adeboni/laser-projector/README.md

# Room-scale Quad Laser Projecter

This project is for a quadruple laser projection controller, aimed at supporting room-scale projections
