adeboni/laser-projector/2024/hardware/combo_laser_driver/notes.txt

Laser Diode Settings:
Red = 3.3 V / 46 mA
Green = 7.2 V / 27 mA
Blue = 7.2 V / 44 mA
