adeboni/laser-projector/2023/hardware/15v_power/15v_power.step

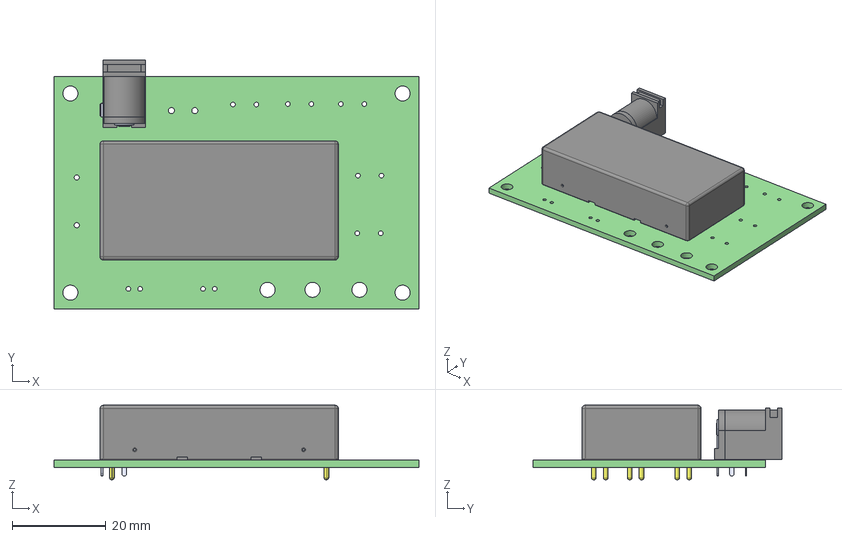
[picture p1: CAD file, 2022-12-08]
2023/hardware/15v_power/15v_power.step
77.8 x 53.1 x 15.9 mm
15v_power PCB
