adeboni/laser-projector/2023/hardware/4x_laser_controller_fp/4x_laser_controller_fp.step

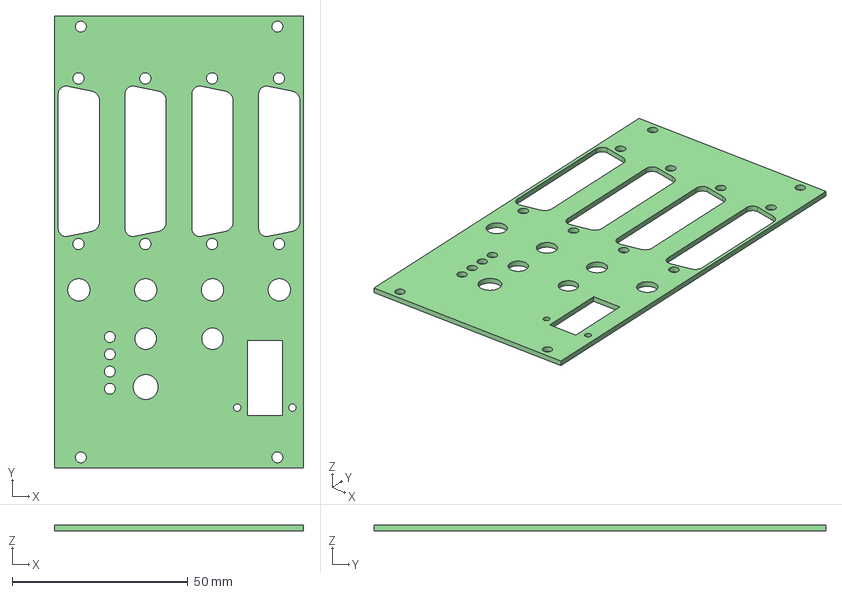
[picture p2: CAD file, 2022-12-08]
2023/hardware/4x_laser_controller_fp/4x_laser_controller_fp.step
70.8 x 128.5 x 1.60 mm
