adeboni/laser-projector/2023/software/extras/cube.stl

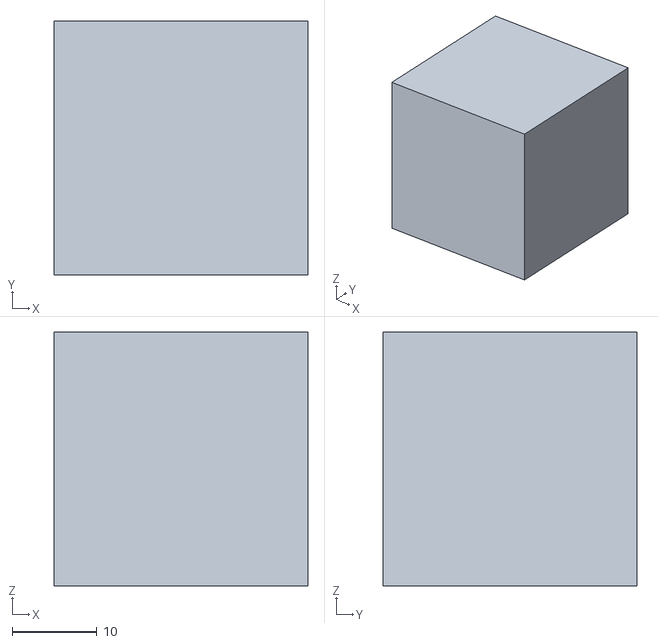
[picture p3: CAD file, 2022-12-08]
2023/software/extras/cube.stl
30.0 x 30.0 x 30.0
