adeboni/laser-projector/2024/hardware/combo_laser_driver/cad/LDNP-470MC--3DModel-STEP-56544.STEP

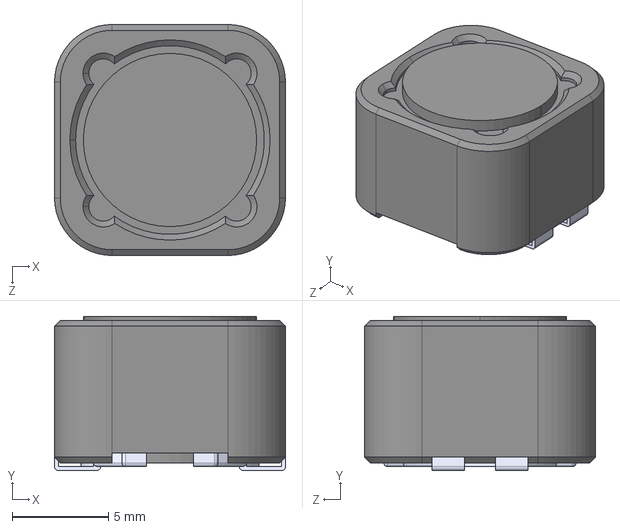
[picture p4: CAD file, 2023-11-15]
2024/hardware/combo_laser_driver/cad/LDNP-470MC--3DModel-STEP-56544.STEP
12.0 x 8.00 x 12.0 mm
