adeboni/laser-projector/2024/hardware/combo_laser_driver/cad/c-0641737-01-g-3d.stp

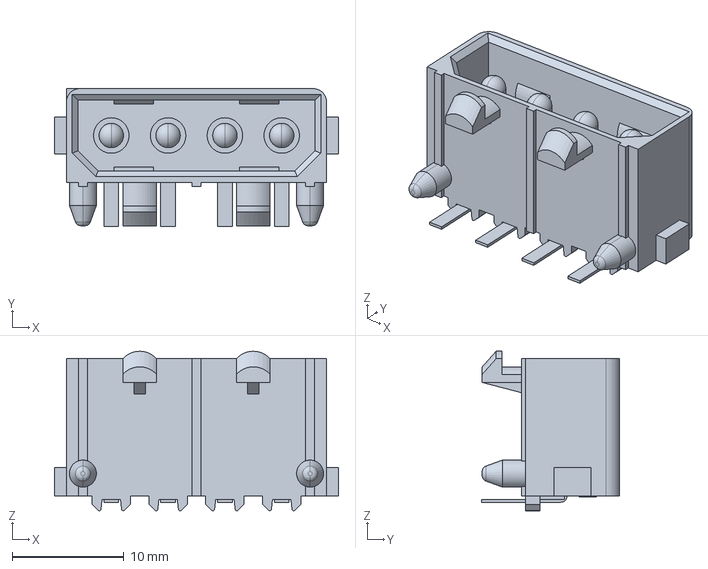
[picture p5: CAD file, 2023-11-15]
2024/hardware/combo_laser_driver/cad/c-0641737-01-g-3d.stp
25.4 x 12.3 x 14.3 mm
