adeboni/laser-projector/2024/hardware/combo_laser_driver/cad/CSP-USC16-TR--3DModel-STEP-468060.STEP

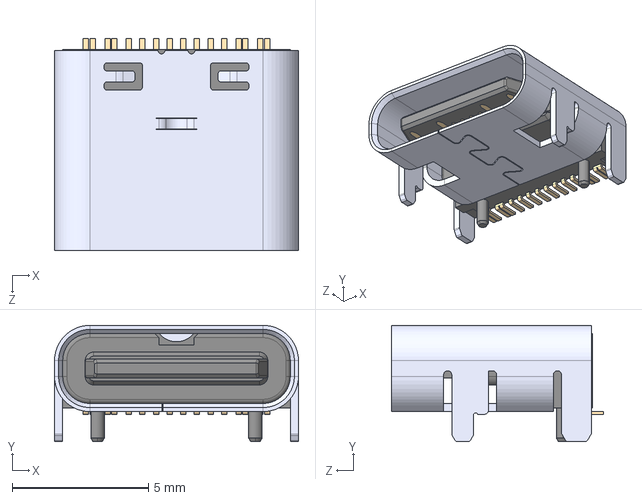
[picture p6: CAD file, 2023-11-15]
2024/hardware/combo_laser_driver/cad/CSP-USC16-TR--3DModel-STEP-468060.STEP
8.94 x 4.26 x 7.75 mm
