adeboni/laser-projector/2024/hardware/combo_laser_driver/cad/7499010121A (rev1).stp

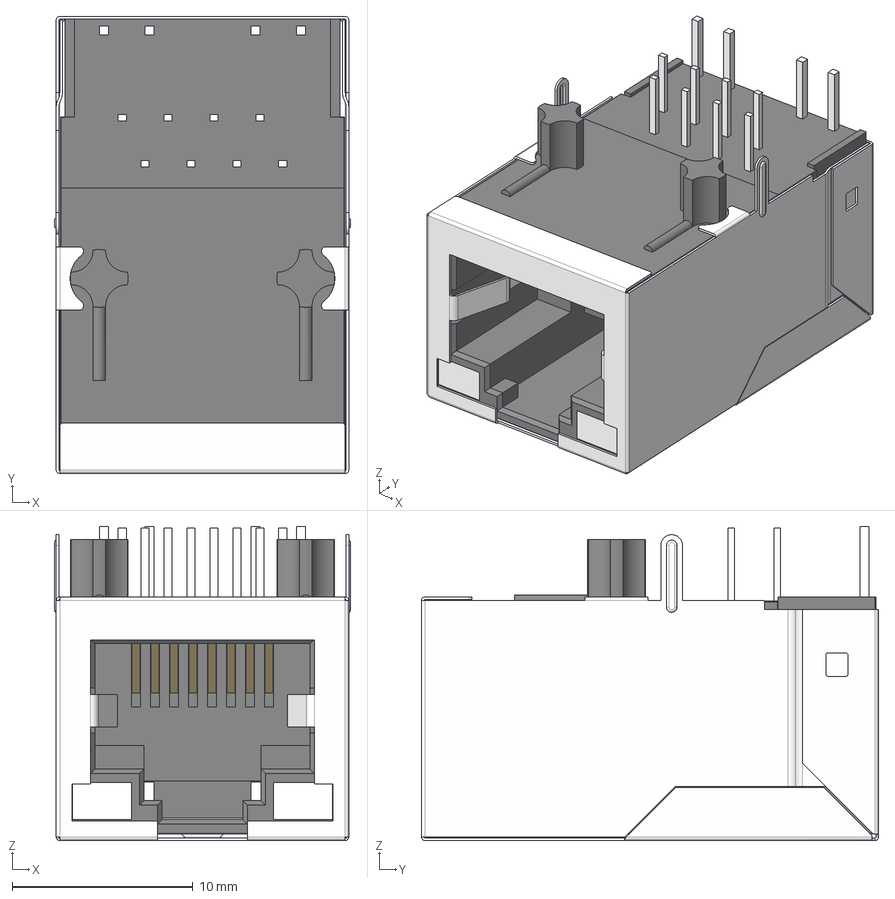
[picture p7: CAD file, 2023-11-15]
2024/hardware/combo_laser_driver/cad/7499010121A (rev1).stp
16.4 x 25.3 x 17.4 mm
Insulator
Insulator_2
Shielding
LED x 2
