adeboni/laser-projector/2024/hardware/combo_laser_driver/cad/76829-0004--3DModel-STEP-194946.STEP

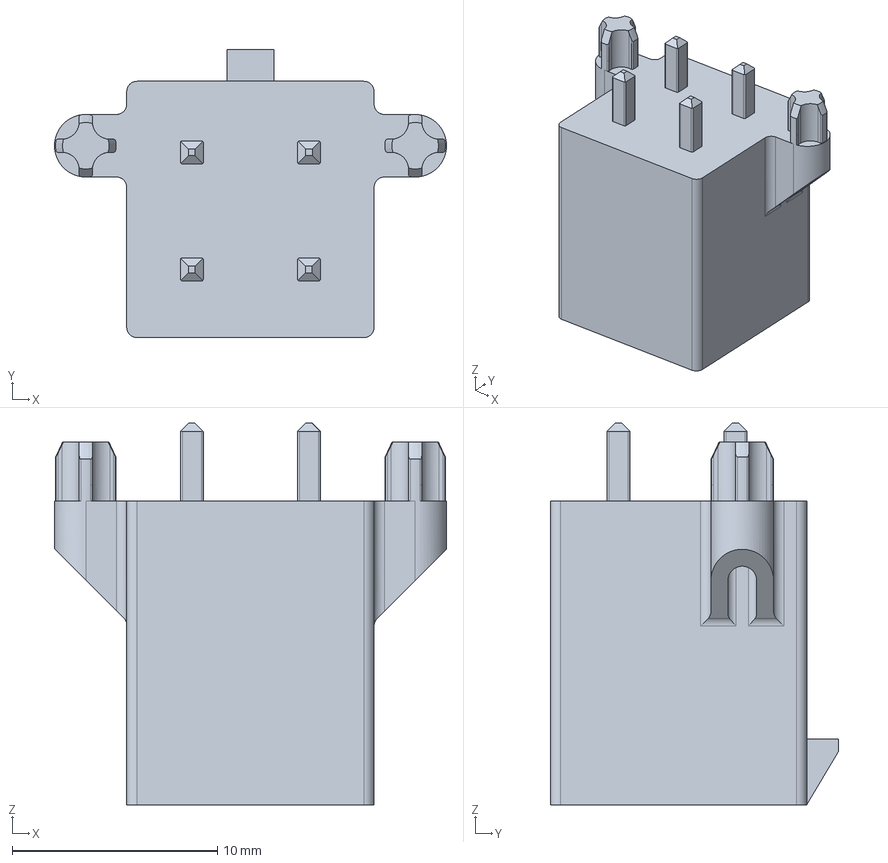
[picture p8: CAD file, 2023-11-15]
2024/hardware/combo_laser_driver/cad/76829-0004--3DModel-STEP-194946.STEP
19.1 x 14.0 x 18.6 mm
