adeboni/laser-projector/2024/hardware/combo_laser_driver/combo_laser_driver.pdf

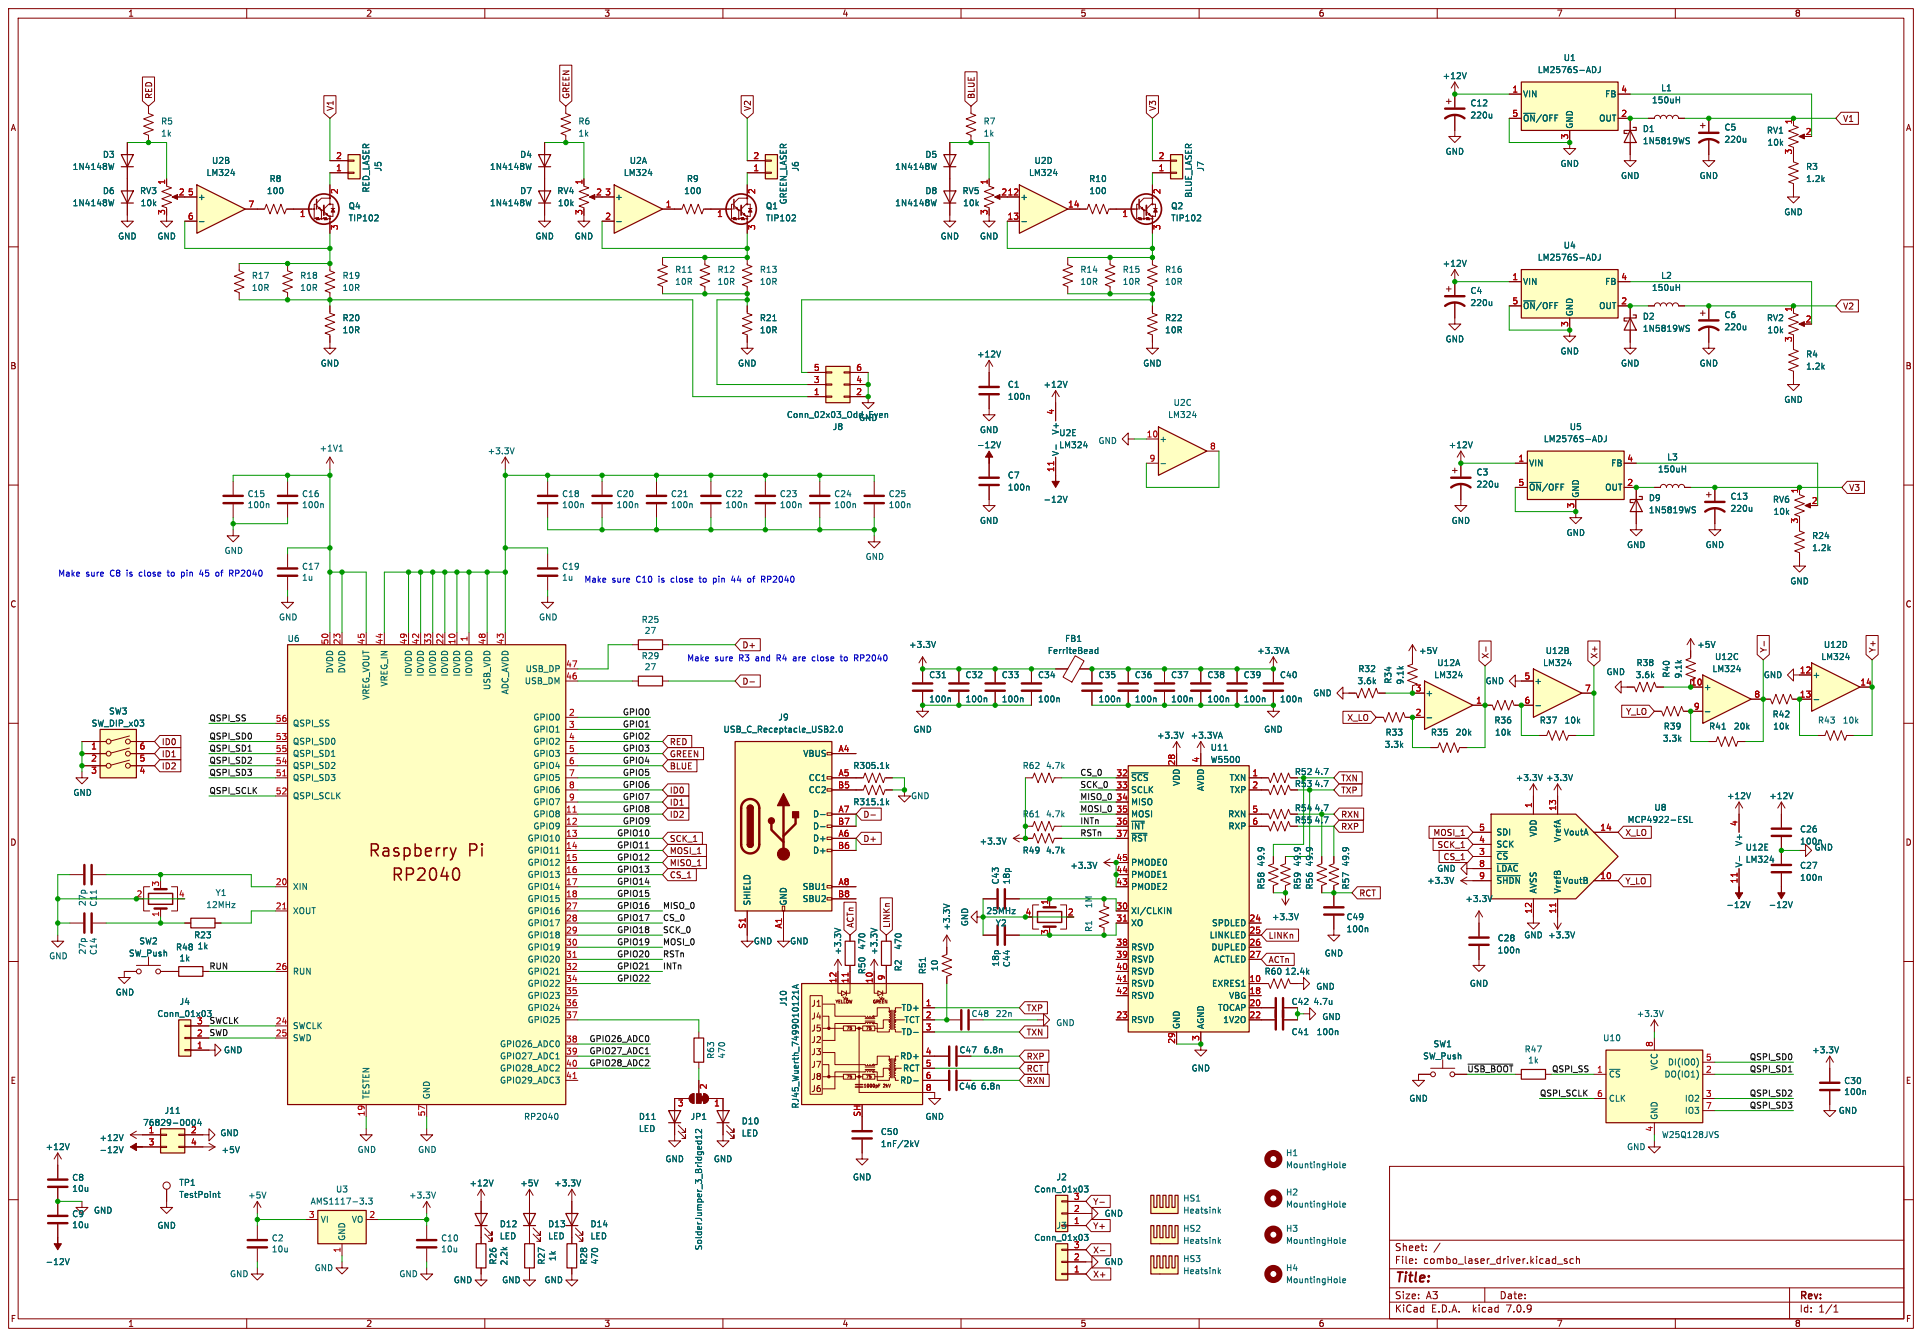
[picture p9: page 1]

3 FB 4 ~{ON}/OFF 5 GND

3 FB 4 ~{ON}/OFF 5 GND GND

1 IOVDD 10 GPIO8 11 GPIO9 12 GPIO10 13 GPIO11 14 GPIO12 15 GPIO13 16 GPIO14 17 GPIO15 18 TESTEN 19 GPIO0 2 XIN 20 XOUT 21 IOVDD 22 DVDD 23 SWCLK 24 SWD 25 RUN 26 GPIO16 27 GPIO17 28 GPIO18 29 GPIO1 3 GPIO19 30 GPIO20 31 GPIO21 32 IOVDD 33 GPIO22 34 GPIO23 35 GPIO24 36 GPIO25 37 GPIO26_ADC0 38 GPIO27_ADC1 39 GPIO2 4 GPIO28_ADC2 40 GPIO29_ADC3 41 IOVDD 42 ADC_AVDD 43 VREG_IN 44 VREG_VOUT 45 USB_DM 46 USB_DP 47 USB_VDD 48 IOVDD 49 GPIO3 5 DVDD 50 QSPI_SD3 51 QSPI_SCLK 52 QSPI_SD0 53 QSPI_SD2 54 QSPI_SD1 55 QSPI_SS 56 GND 57 GPIO4 6 GPIO5 7 GPIO6 8 GPIO7 9 U6 RP2040

4 RSVD 40 RSVD 41 RSVD 42 PMODE2 43 PMODE1 44 PMODE0 45 RXN 5 RXP 6 +3.3V C35

4 RSVD 40 RSVD 41 RSVD 42 PMODE2 43 PMODE1 44 PMODE0 45 RXN 5 RXP 6 U11 W5500 +3.3V

3 XI/CLKIN 30 XO 31 ~{SCS} 32 SCLK 33 MISO 34 MOSI 35 ~{INT} 36 ~{RST} 37 RSVD 38 RSVD 39 AVDD

1 VoutB 10 VrefB 11 AVSS 12 VrefA 13 VoutA 14 ~{CS} 3 SCK 4 SDI 5 ~{LDAC} 8 ~{SHDN} 9 U8 MCP4922-ESL +3.3V

1 VoutB 10 VrefB 11 AVSS 12 VrefA 13 VoutA 14 ~{CS} 3 SCK 4 SDI 5 ~{LDAC} 8 ~{SHDN} 9 +3.3V

1 VO 2 VI 3 U3 AMS1117-3.3 GND GND

H3 MountingHole H4 MountingHole H1 MountingHole H2 MountingHole GND

Id: 1/1 Title: File: combo_laser_driver.kicad_sch Sheet: /
