adeboni/laser-projector/2023/hardware/mini_laser_driver/mini_laser_driver.kicad_pcb

## KiCad design 2023/hardware/mini_laser_driver/mini_laser_driver.kicad_pcb (2023-01-10)

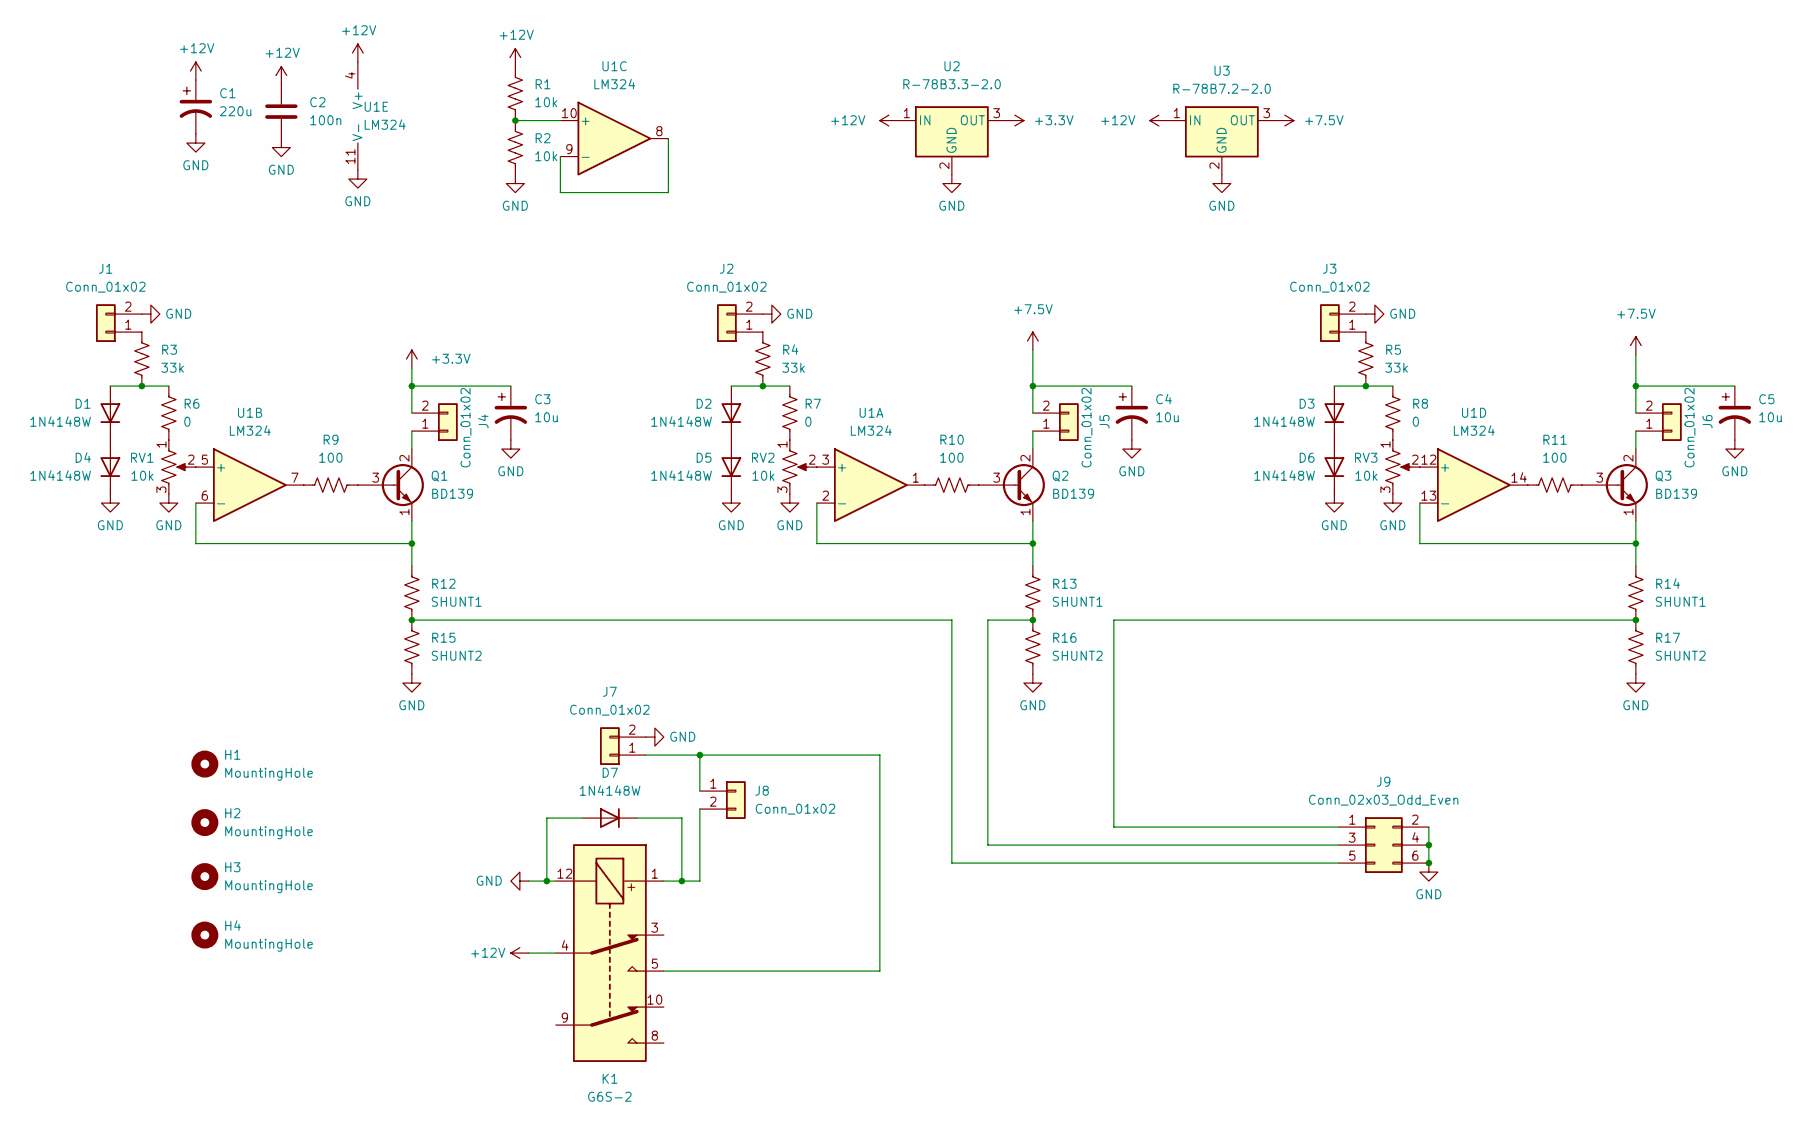
[picture p10: schematic mini_laser_driver.kicad_sch]

Parts:
C1: 220u; CP_Radial_D10.0mm_P5.00mm
C2: 100n; C_0603_1608Metric
C3, C4, C5: 10u; CP_Radial_D5.0mm_P2.50mm
D1, D2, D3, D4, D5, D6, D7: 1N4148W; D_SOD-123
H1, H2, H3, H4: MountingHole; MountingHole_3.2mm_M3
J1, J2, J3, J4, J5, J6, J7: Conn_01x02; JST_XH_B2B-XH-A_1x02_P2.50mm_Vertical
J8: Conn_01x02; PinHeader_1x02_P2.54mm_Vertical
J9: Conn_02x03_Odd_Even; PinHeader_2x03_P2.54mm_Vertical
K1: G6S-2; Relay_DPDT_Omron_G6S-2
Q1, Q2, Q3: BD139; TO-126-3_Vertical
R1, R2: 10k; R_0603_1608Metric
R3, R4, R5: 33k; R_0603_1608Metric
R6, R7, R8: 0; R_0603_1608Metric
R9, R10, R11: 100; R_0603_1608Metric
R12, R13, R14: SHUNT1; R_Axial_DIN0204_L3.6mm_D1.6mm_P1.90mm_Vertical
R15, R16, R17: SHUNT2; R_Axial_DIN0204_L3.6mm_D1.6mm_P1.90mm_Vertical
RV1, RV2, RV3: 10k; Potentiometer_Bourns_3296W_Vertical
U1: LM324; SOIC-14_3.9x8.7mm_P1.27mm
U2: R-78B3.3-2.0; Converter_DCDC_RECOM_R-78B-2.0_THT
U3: R-78B7.2-2.0; Converter_DCDC_RECOM_R-78B-2.0_THT

Connections:
+3V3: C3.1, J4.2, U2.3 (OUT)
+7.5V: C4.1, C5.1, J5.2, J6.2, U3.3 (OUT)
+12V: C1.1, C2.1, K1.4, R1.2, U1.4 (V+), U2.1 (IN), U3.1 (IN)
GND: C1.2, C2.2, C3.2, C4.2, C5.2, D4.1 (K), D5.1 (K), D6.1 (K), D7.2 (A), J1.2, J2.2, J3.2, J7.2, J9.2, J9.4, J9.6, K1.12, R2.1, R15.2, R16.2, R17.2, RV1.3, RV2.3, RV3.3, U1.11 (V-), U2.2 (GND), U3.2 (GND)
unnamed: D1.1 (K), D4.2 (A)
unnamed: D1.2 (A), R3.1, R6.2
unnamed: D2.1 (K), D5.2 (A)
unnamed: D2.2 (A), R4.1, R7.2
unnamed: D3.1 (K), D6.2 (A)
unnamed: D3.2 (A), R5.1, R8.2
unnamed: D7.1 (K), J8.2, K1.1
unnamed: J1.1, R3.2
unnamed: J2.1, R4.2
unnamed: J3.1, R5.2
unnamed: J4.1, Q1.2 (C)
unnamed: J5.1, Q2.2 (C)
unnamed: J6.1, Q3.2 (C)
unnamed: J7.1, J8.1, K1.5
unnamed: J9.1, R14.2, R17.1
unnamed: J9.3, R13.2, R16.1
unnamed: Q1.1 (E), R12.1, U1.6 (-)
unnamed: Q1.3 (B), R9.2
unnamed: Q2.1 (E), R13.1, U1.2 (-)
unnamed: Q2.3 (B), R10.2
unnamed: Q3.1 (E), R14.1, U1.13 (-)
unnamed: Q3.3 (B), R11.2
unnamed: R1.1, R2.2, U1.10 (+)
unnamed: R6.1, RV1.1
unnamed: R7.1, RV2.1
unnamed: R8.1, RV3.1
unnamed: R9.1, U1.7
unnamed: R10.1, U1.1
unnamed: R11.1, U1.14
unnamed: J9.5, R12.2, R15.1
unnamed: RV1.2, U1.5 (+)
unnamed: RV2.2, U1.3 (+)
unnamed: RV3.2, U1.12 (+)
unnamed: U1.8, U1.9 (-)

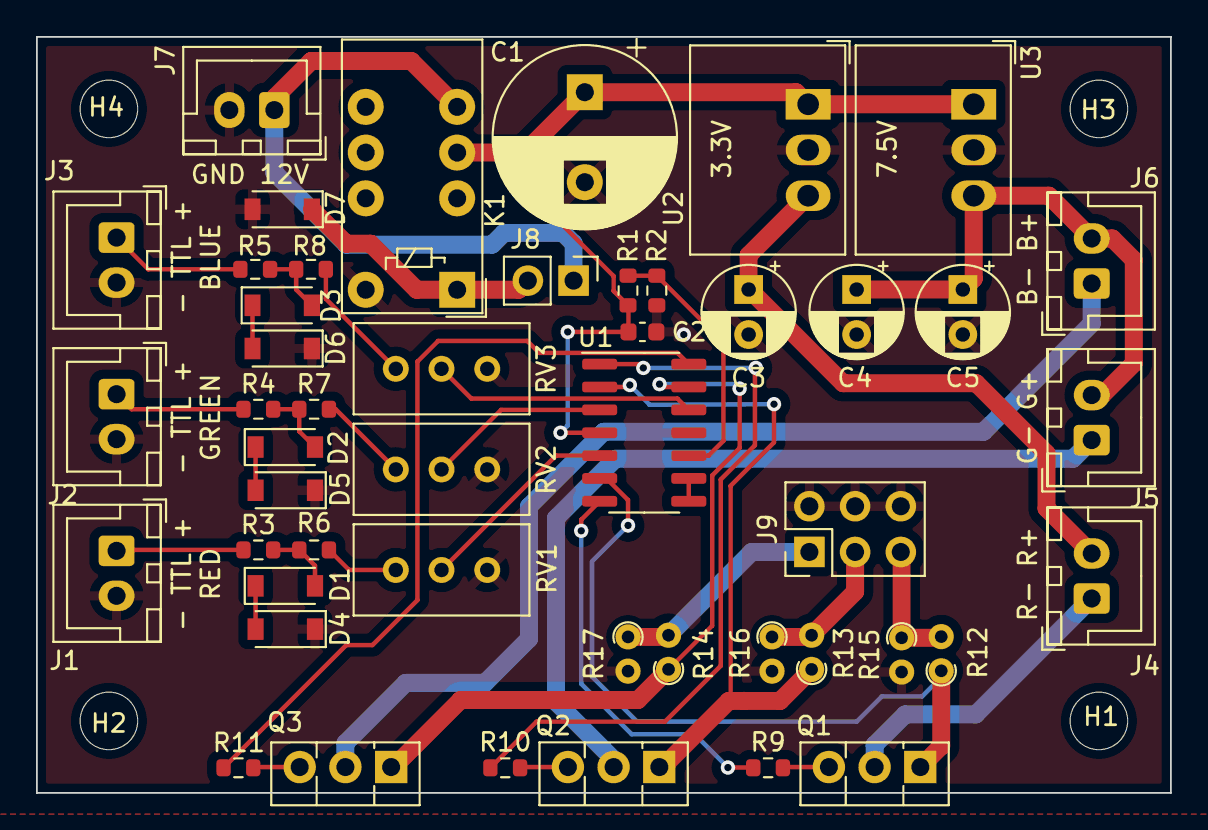
[picture p11: board mini_laser_driver.kicad_pcb from above]

Board: 2 copper layers, 63.0 x 42.0 mm, 52 parts (0 on the bottom side), 38 nets.
