adeboni/laser-projector/2023/hardware/canbus_controller/canbus_controller.kicad_pcb

## KiCad design 2023/hardware/canbus_controller/canbus_controller.kicad_pcb (2023-11-15)

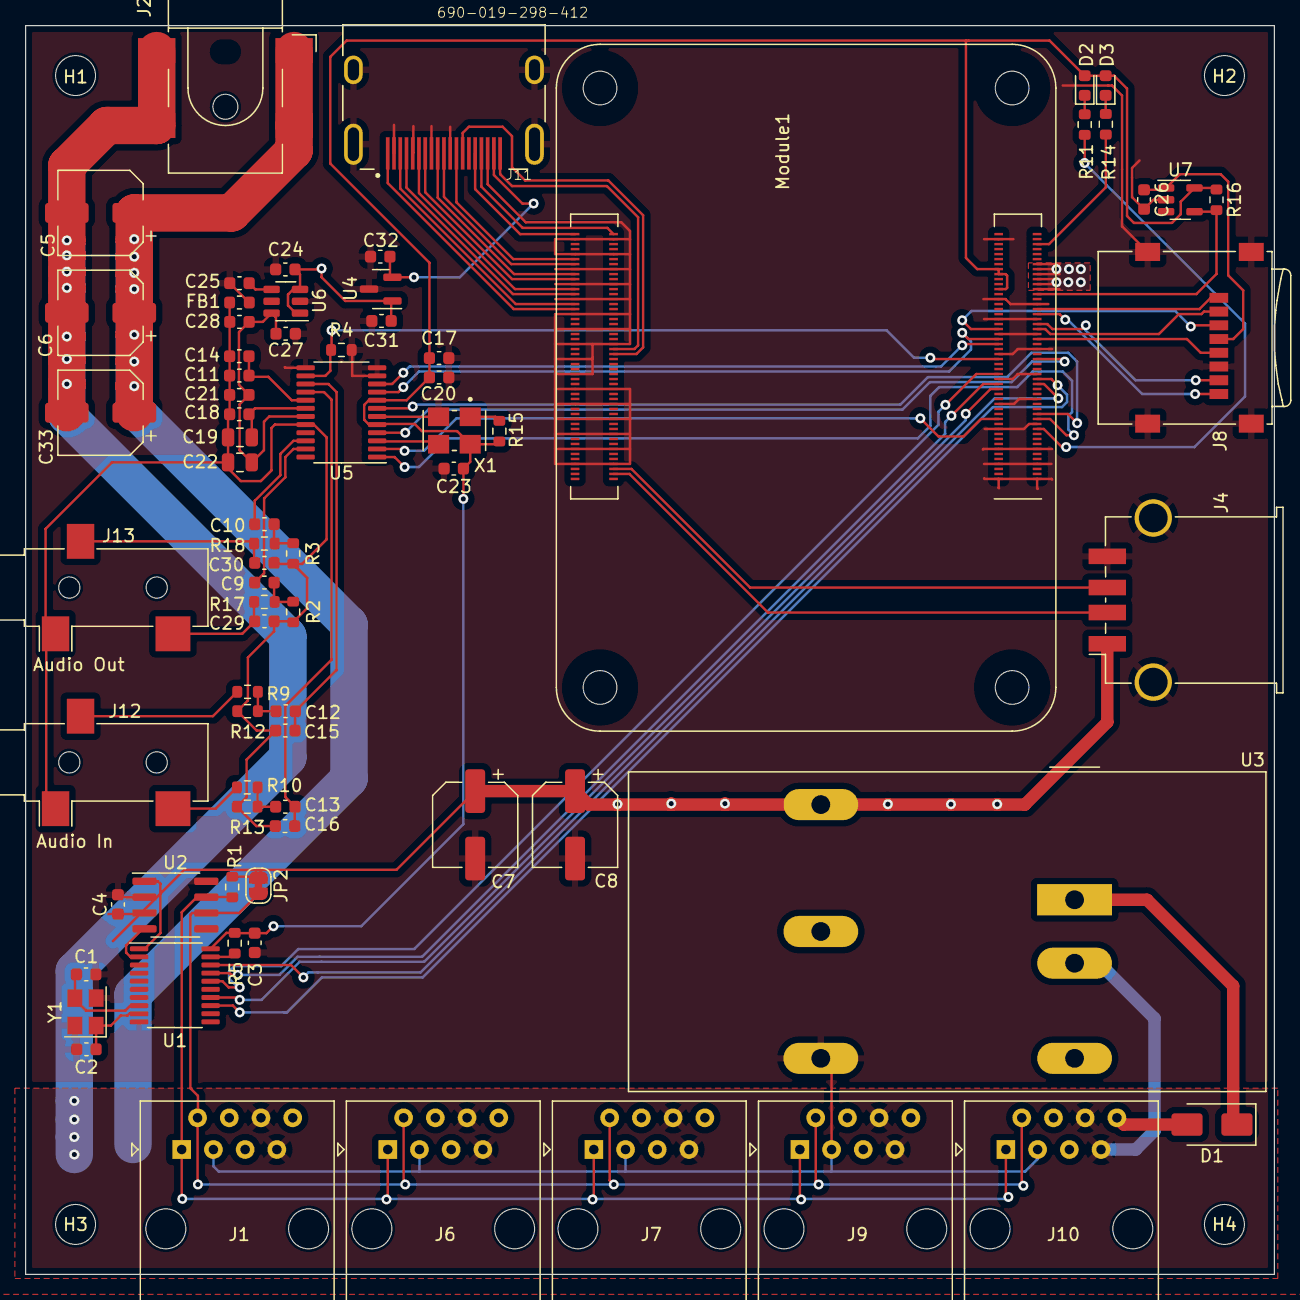
[picture p14: board canbus_controller.kicad_pcb from above]

Board: 2 copper layers, 100.0 x 100.0 mm, 78 parts (0 on the bottom side), 72 nets.

Parts:
C1, C2: 27p; C_0603_1608Metric
C3, C4, C11, C18, C20, C21, C24, C28, C31, C32: 100n; C_0603_1608Metric
C5, C6, C7, C8, C33: 100u; CP_Elec_6.3x5.8
C9, C10: 3.3u; C_0603_1608Metric
C12, C13, C14, C17, C26, C27: 10u; C_0603_1608Metric
C15, C16: 220p; C_0603_1608Metric
C19, C22: 47u; C_0805_2012Metric
C23, C25: 10n; C_0603_1608Metric
C29, C30: 2.7n; C_0603_1608Metric
D1: SS54; D_SMA
D2: LED Green; LED_0603_1608Metric
D3: LED Red; LED_0603_1608Metric
FB1: FerriteBead_Small; L_0603_1608Metric
H1, H2, H3, H4: MountingHole; MountingHole_3.2mm_M3
J1, J6, J7, J9, J10: RJ45; RJ45_Amphenol_54602-x08_Horizontal
J2: Barrel_Jack_Switch; BarrelJack_CLIFF_FC681465S_SMT_Horizontal
J4: USB_A; USB_A_TE_292303-7_Horizontal
J8: Micro_SD_Card; microSD_HC_Wuerth_693072010801
J11: 690-019-298-412; EDAC 690-019-298-412
J12, J13: AudioJack3; Jack_3.5mm_CUI_SJ-3523-SMT_Horizontal
JP2: SolderJumper_2_Bridged; SolderJumper-2_P1.3mm_Bridged_RoundedPad1.0x1.5mm
Module1: ComputeModule4; Raspberry-Pi-4-Compute-Module
R1: 120; R_0603_1608Metric
R2, R3, R4, R5, R12, R13, R15: 10k; R_0603_1608Metric
R9, R10: 4.99k; R_0603_1608Metric
R11, R14: 1k; R_0603_1608Metric
R16: 12K 1%; R_0603_1608Metric
R17, R18: 590; R_0603_1608Metric
U1: MCP2515-xST; TSSOP-20_4.4x6.5mm_P0.65mm
U2: MCP2551-I-SN; SOIC-8_3.9x4.9mm_P1.27mm
U3: TEN20-2411WIN; Converter_DCDC_TRACO_TEN20-xxxx_THT
U4: RT9742SNGV; SOT-23
U5: CS4270; TSSOP-24_4.4x7.8mm_P0.65mm
U6: TPS79301-EP; SOT-23-6
U7: RT9742GGJ5; SOT-23-5
X1: 12.288MHz; XTAL_ASFL1-8.000MHZ-EC-T
Y1: 8Mhz; Crystal_SMD_3225-4Pin_3.2x2.5mm

Connections:
+5VA: C21.1, C22.1, C27.1, C28.1, U5.19 (VA), U6.6 (OUT)
/+3.3v: C3.1, C17.1, C20.1, C23.1, D2.2 (A), D3.2 (A), Module1.78 (GPIO_VREF(1.8v/3.3v_Input)), Module1.84 (+3.3v_(Output)), Module1.86 (+3.3v_(Output)), R5.2, R15.1, R16.1, U1.20 (VDD), U5.5 (VD), U5.8 (VLC), U7.5 (IN), X1.4 (Vdd)
/+5v: C4.1, C7.1, C8.1, C24.1, C31.1, J4.1 (VBUS), Module1.77 (+5v_(Input)), Module1.79 (+5v_(Input)), Module1.81 (+5v_(Input)), Module1.83 (+5v_(Input)), Module1.85 (+5v_(Input)), Module1.87 (+5v_(Input)), U2.3 (VDD), U3.3 (VOUT+), U4.1 (IN), U6.1 (IN), U6.3 (EN)
/+12v: C5.1, C6.1, C33.1, D1.2 (A), J1.5, J1.8, J2.1, J6.5, J6.8, J7.5, J7.8, J9.5, J9.8, J10.5, J10.8
/HDMI0_CEC: J11.13 (CEC), Module1.151 (HDMI0_CEC)
/HDMI0_CK_N: J11.12 (CK-), Module1.190 (HDMI0_CLK_N)
/HDMI0_CK_P: J11.10 (CK+), Module1.188 (HDMI0_CLK_P)
/HDMI0_D0_N: J11.9 (D0-), Module1.184 (HDMI0_TX0_N)
/HDMI0_D0_P: J11.7 (D0+), Module1.182 (HDMI0_TX0_P)
/HDMI0_D1_N: J11.6 (D1-), Module1.178 (HDMI0_TX1_N)
/HDMI0_D1_P: J11.4 (D1+), Module1.176 (HDMI0_TX1_P)
/HDMI0_D2_N: J11.3 (D2-), Module1.172 (HDMI0_TX2_N)
/HDMI0_D2_P: J11.1 (D2+), Module1.170 (HDMI0_TX2_P)
/HDMI0_HOTPLUG: J11.19 (HPD/HEAC-), Module1.153 (HDMI0_HOTPLUG)
/HDMI0_SCL: J11.15 (SCL), Module1.200 (HDMI0_SCL)
/HDMI0_SDA: J11.16 (SDA), Module1.199 (HDMI0_SDA)
/HDMI_5v: C32.1, J11.18 (+5V), U4.2 (OUT)
/SD_CLK: J8.5 (CLK), Module1.57 (SD_CLK)
/SD_CMD: J8.3 (CMD), Module1.62 (SD_CMD)
/SD_DAT0: J8.7 (DAT0), Module1.63 (SD_DAT0)
/SD_DAT1: J8.8 (DAT1), Module1.67 (SD_DAT1)
/SD_DAT2: J8.1 (DAT2), Module1.69 (SD_DAT2)
/SD_DAT3: J8.2 (DAT3/CD), Module1.61 (SD_DAT3)
/SD_PWR: C26.1, J8.4 (VDD), U7.1 (OUT)
/SD_PWR_ON: Module1.75 (SD_PWR_ON), R16.2, U7.4 (EN)
/USBD_N: J4.2 (D-), Module1.103 (USB2_N)
/USBD_P: J4.3 (D+), Module1.105 (USB2_P)
/nPWR_LED: Module1.95 (nPI_LED_PWR), R14.2
CAN_CS: Module1.39 (GPIO8), U1.18 (~CS)
CAN_H: J1.1, J6.1, J7.1, J9.1, J10.1, R1.2, U2.7 (CANH)
CAN_L: J1.2, J6.2, J7.2, J9.2, J10.2, JP2.2 (B), U2.6 (CANL)
CAN_SCK: Module1.38 (GPIO11), U1.14 (SCK)
CAN_SI: Module1.44 (GPIO10), U1.16 (SI)
CAN_SO: Module1.40 (GPIO9), U1.17 (SO)
GND: C1.2, C2.2, C3.2, C4.2, C7.2, C8.2, C17.2, C20.2, C23.2, C24.2, C25.2, C26.2, C27.2, C31.2, C32.2, FB1.2, J1.3, J4.4 (GND), J4.5 (Shield), J6.3, J7.3, J8.6 (VSS), J8.9 (SHIELD), J9.3, J10.3, J11.2 (D2S), J11.5 (D1S), J11.8 (D0S), J11.11 (CKS), J11.17 (GND), J11.SH1 (SH), J11.SH2 (SH), J11.SH3 (SH), J11.SH4 (SH), Module1.1 (GND), Module1.2 (GND), Module1.7 (GND), Module1.8 (GND), Module1.13 (GND), Module1.14 (GND), Module1.22 (GND), Module1.23 (GND), Module1.32 (GND), Module1.33 (GND), Module1.42 (GND), Module1.43 (GND), Module1.52 (GND), Module1.53 (GND), Module1.59 (GND), Module1.60 (GND), Module1.65 (GND), Module1.66 (GND), Module1.71 (GND), Module1.74 (GND), Module1.98 (GND), Module1.107 (GND), Module1.108 (GND), Module1.113 (GND), Module1.114 (GND), Module1.119 (GND), Module1.120 (GND), Module1.125 (GND), Module1.126 (GND), Module1.131 (GND), Module1.132 (GND), Module1.137 (GND), Module1.138 (GND), Module1.144 (GND), Module1.150 (GND), Module1.155 (GND), Module1.156 (GND), Module1.161 (GND), Module1.162 (GND), Module1.167 (GND), Module1.168 (GND), Module1.173 (GND), Module1.174 (GND), Module1.179 (GND), Module1.180 (GND), Module1.185 (GND), Module1.186 (GND), Module1.191 (GND), Module1.192 (GND), Module1.197 (GND), Module1.198 (GND), R4.1, U1.10 (VSS), U2.2 (VSS), U2.8 (Rs), U3.5 (VOUT-), U4.3 (GND), U5.6 (DGND), U5.11 (AD0/~CS/I2S/~LJ), U5.12 (AD1/CDIN/MDIV1), U5.13 (AD2/MDIV2), U6.2 (GND), U7.2 (GND), X1.2 (GND), Y1.2, Y1.4
GNDA: C11.2, C14.2, C15.1, C16.1, C18.2, C19.2, C21.2, C22.2, C28.2, C29.1, C30.1, FB1.1, J12.S, J13.S, R2.2, R3.2, R12.2, R13.2, U5.20 (AGND)
GNDPWR: C5.2, C6.2, C33.2, J1.6, J1.7, J2.2, J2.3, J6.6, J6.7, J7.6, J7.7, J9.6, J9.7, J10.6, J10.7, U3.2 (VIN-)
GPIO25: Module1.41 (GPIO25), U1.13 (~INT)
INA: C12.2, C15.2, U5.15 (AINA)
INB: C13.2, C16.2, U5.16 (AINB)
LRCLK: Module1.26 (GPIO19), U5.2 (LRCLK)
MCLK: U5.3 (MCLK), X1.3 (OUT)
unnamed: C9.2, R2.1, R17.2
unnamed: C10.2, R3.1, R18.2
unnamed: C12.1, R9.1, R12.1
unnamed: C13.1, R10.1, R13.1
unnamed: C29.2, J13.T, R17.1
unnamed: C30.2, J13.R, R18.1
unnamed: D1.1 (K), U3.1 (VIN+)
unnamed: D2.1 (K), R11.1
unnamed: D3.1 (K), R14.1
unnamed: J12.R, R9.2
unnamed: J12.T, R10.2
unnamed: JP2.1 (A), R1.1
unnamed: Module1.21 (PI_nLED_Activity), R11.2
unnamed: C2.1, U1.9 (OSC1), Y1.1
unnamed: C1.1, U1.8 (OSC2), Y1.3
unnamed: U1.2 (RXCAN), U2.4 (RXD)
unnamed: U1.1 (TXCAN), U2.1 (TXD)
unnamed: R5.1, U1.19 (~RESET)
unnamed: C18.1, C19.1, U5.18 (FIL+)
unnamed: C11.1, C14.1, U5.17 (VQ)
unnamed: C25.1, U6.4 (BP)
unnamed: R15.2, X1.1 (EN)
OUTA: C10.1, U5.22 (OUTA)
OUTB: C9.1, U5.23 (OUTB)
R_CODEC: Module1.50 (GPIO17), R4.2, U5.14 (~RST)
SCLK: Module1.49 (GPIO18), U5.4 (SCLK)
SCL_CODEC: Module1.56 (GPIO3), U5.10 (SCL/CCLK/M0)
SDA_CODEC: Module1.58 (GPIO2), U5.9 (SDA/CDOUT/M1)
SDIN: Module1.25 (GPIO21), U5.1 (SDIN)
SDOUT: Module1.27 (GPIO20), U5.7 (SDOUT)
