adeboni/laser-projector/2023/hardware/analog_to_pwm/analog_to_pwm.kicad_pcb

## KiCad design 2023/hardware/analog_to_pwm/analog_to_pwm.kicad_pcb (2022-12-08)

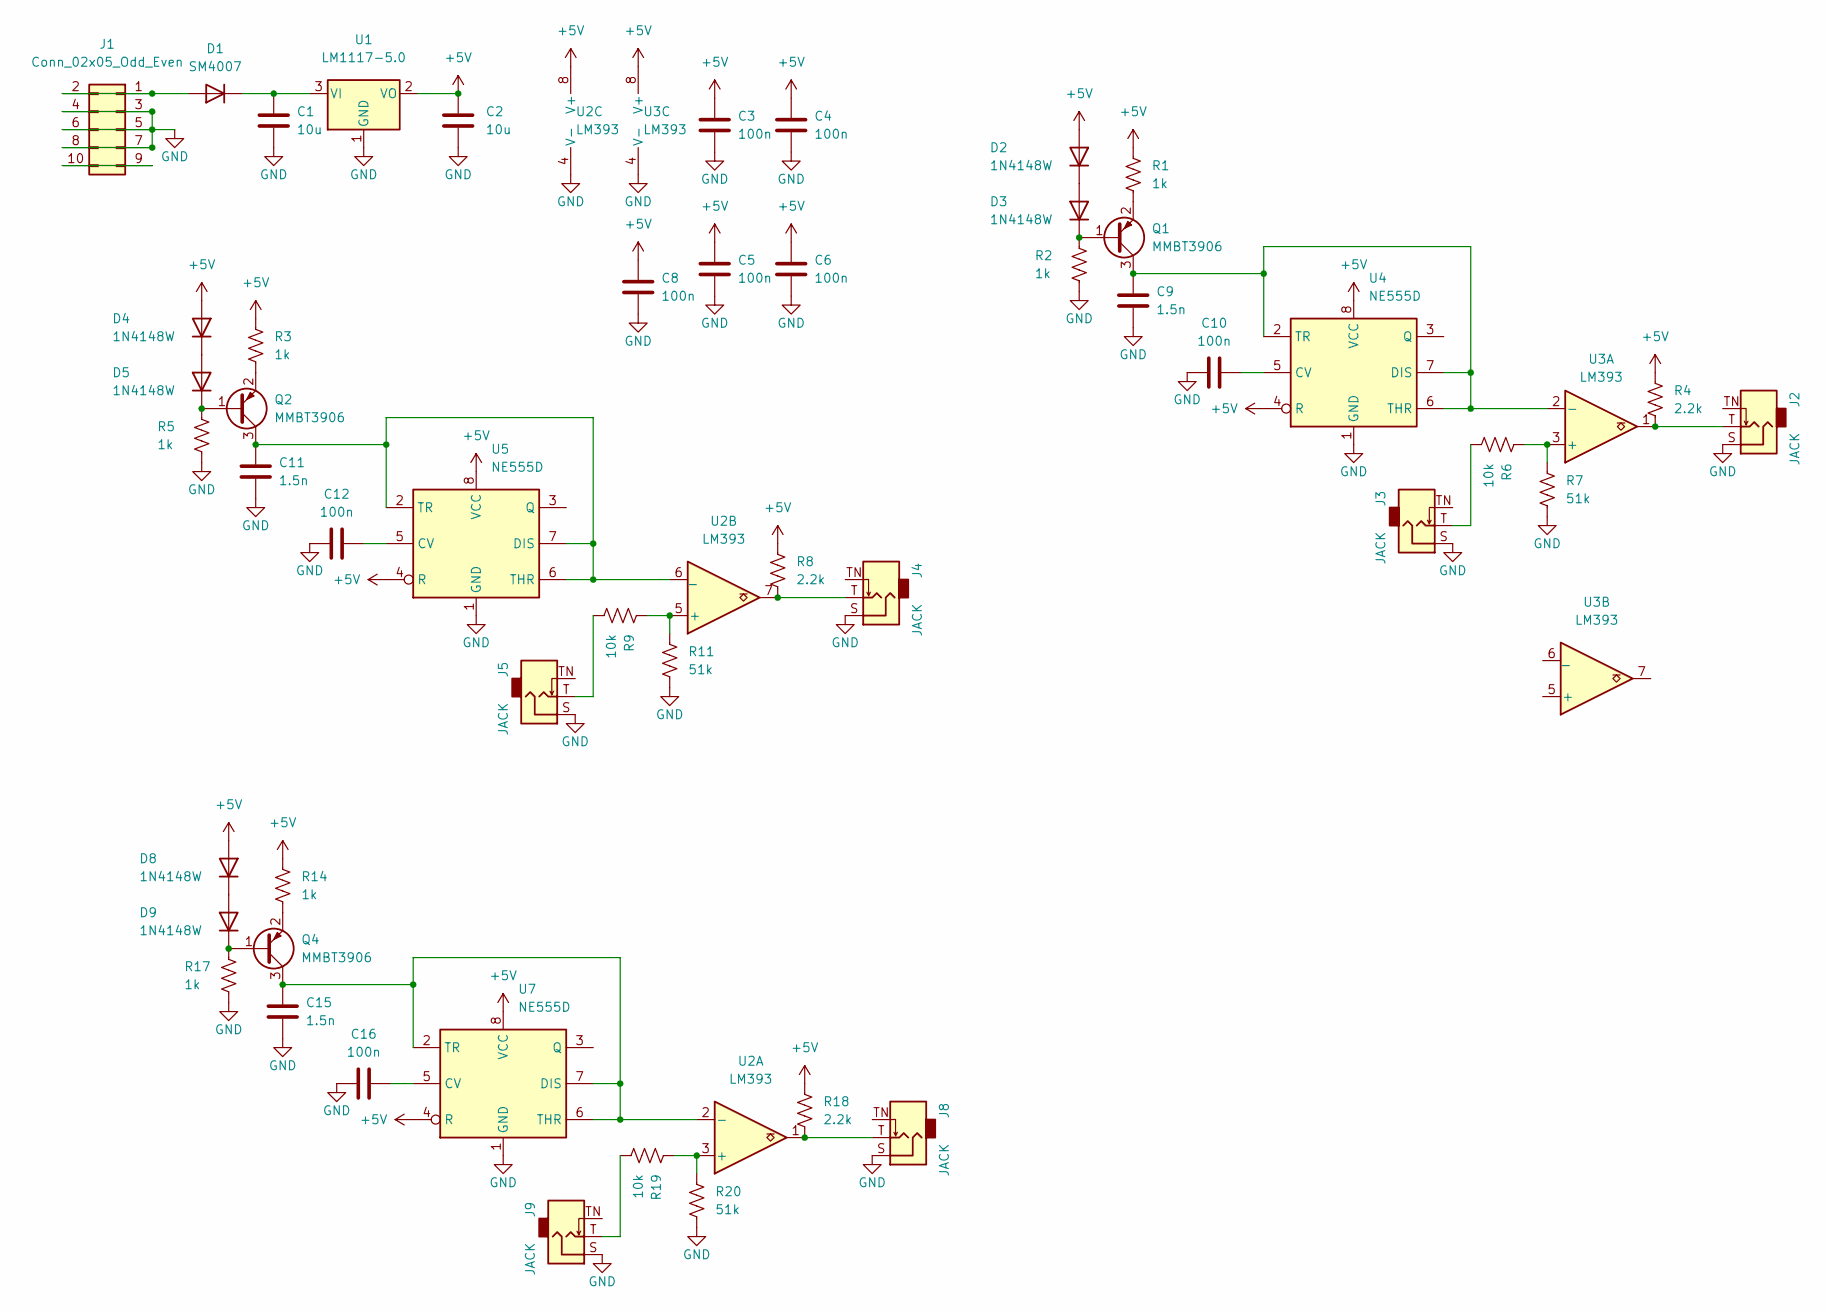
[picture p15: schematic analog_to_pwm.kicad_sch]

Parts:
C1, C2: 10u; C_0603_1608Metric
C3, C4, C5, C6, C8, C10, C12, C16: 100n; C_0603_1608Metric
C9, C11, C15: 1.5n; C_0603_1608Metric
D1: SM4007; D_SOD-123
D2, D3, D4, D5, D8, D9: 1N4148W; D_SOD-123
J1: Conn_02x05_Odd_Even; Pins_2x05_2.54mm_TH_Europower
J2, J3, J4, J5, J8, J9: JACK; Jack_3.5mm_QingPu_WQP-PJ398SM_Vertical_CircularHoles
Q1, Q2, Q4: MMBT3906; SOT-23
R1, R2, R3, R5, R14, R17: 1k; R_0603_1608Metric
R4, R8, R18: 2.2k; R_0603_1608Metric
R6, R9, R19: 10k; R_0603_1608Metric
R7, R11, R20: 51k; R_0603_1608Metric
U1: LM1117-5.0; SOT-223-3_TabPin2
U2, U3: LM393; SOIC-8_3.9x4.9mm_P1.27mm
U4, U5, U7: NE555D; SOIC-8_3.9x4.9mm_P1.27mm

Connections:
+5V: C2.1, C3.1, C4.1, C5.1, C6.1, C8.1, D2.2 (A), D4.2 (A), D8.2 (A), R1.1, R3.1, R4.1, R8.1, R14.1, R18.1, U1.2 (VO), U2.8 (V+), U3.8 (V+), U4.4 (R), U4.8 (VCC), U5.4 (R), U5.8 (VCC), U7.4 (R), U7.8 (VCC)
GND: C1.2, C2.2, C3.2, C4.2, C5.2, C6.2, C8.2, C9.2, C10.1, C11.2, C12.1, C15.2, C16.1, J1.3, J1.4, J1.5, J1.6, J1.7, J1.8, J2.S, J3.S, J4.S, J5.S, J8.S, J9.S, R2.2, R5.2, R7.2, R11.2, R17.2, R20.2, U1.1 (GND), U2.4 (V-), U3.4 (V-), U4.1 (GND), U5.1 (GND), U7.1 (GND)
unnamed: C1.1, D1.1 (K), U1.3 (VI)
unnamed: C9.1, Q1.3 (C), U3.2 (-), U4.2 (TR), U4.6 (THR), U4.7 (DIS)
unnamed: C10.2, U4.5 (CV)
unnamed: C11.1, Q2.3 (C), U2.6 (_), U5.2 (TR), U5.6 (THR), U5.7 (DIS)
unnamed: C12.2, U5.5 (CV)
unnamed: C15.1, Q4.3 (C), U2.2 (-), U7.2 (TR), U7.6 (THR), U7.7 (DIS)
unnamed: C16.2, U7.5 (CV)
unnamed: D1.2 (A), J1.1, J1.2
unnamed: D2.1 (K), D3.2 (A)
unnamed: D3.1 (K), Q1.1 (B), R2.1
unnamed: D4.1 (K), D5.2 (A)
unnamed: D5.1 (K), Q2.1 (B), R5.1
unnamed: D8.1 (K), D9.2 (A)
unnamed: D9.1 (K), Q4.1 (B), R17.1
unnamed: J1.9, J1.10
unnamed: J2.T, R4.2, U3.1
unnamed: J3.T, R6.2
unnamed: J4.T, R8.2, U2.7
unnamed: J5.T, R9.2
unnamed: J8.T, R18.2, U2.1
unnamed: J9.T, R19.2
unnamed: Q1.2 (E), R1.2
unnamed: Q2.2 (E), R3.2
unnamed: Q4.2 (E), R14.2
unnamed: R6.1, R7.1, U3.3 (+)
unnamed: R9.1, R11.1, U2.5 (+)
unnamed: R19.1, R20.1, U2.3 (+)

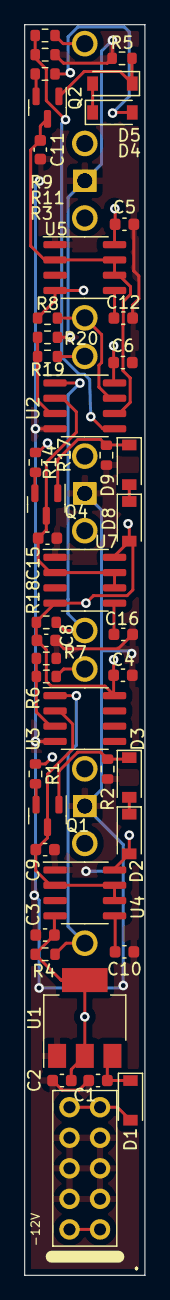
[picture p16: board analog_to_pwm.kicad_pcb from above]

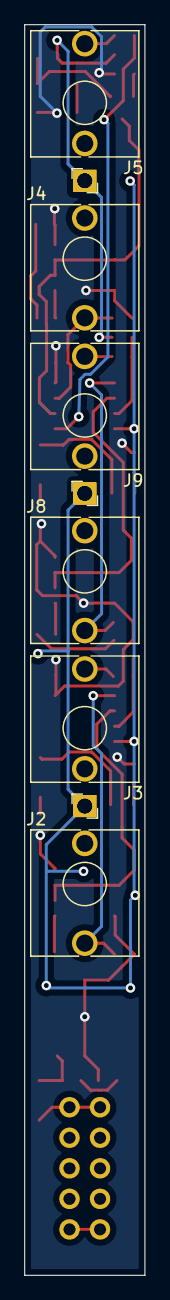
[picture p17: board analog_to_pwm.kicad_pcb from below]

Board: 2 copper layers, 10.0 x 104.0 mm, 51 parts (6 on the bottom side), 29 nets.
