adeboni/laser-projector/2023/hardware/canbus_adapter/canbus_adapter.kicad_pcb

## KiCad design 2023/hardware/canbus_adapter/canbus_adapter.kicad_pcb (2023-11-15)

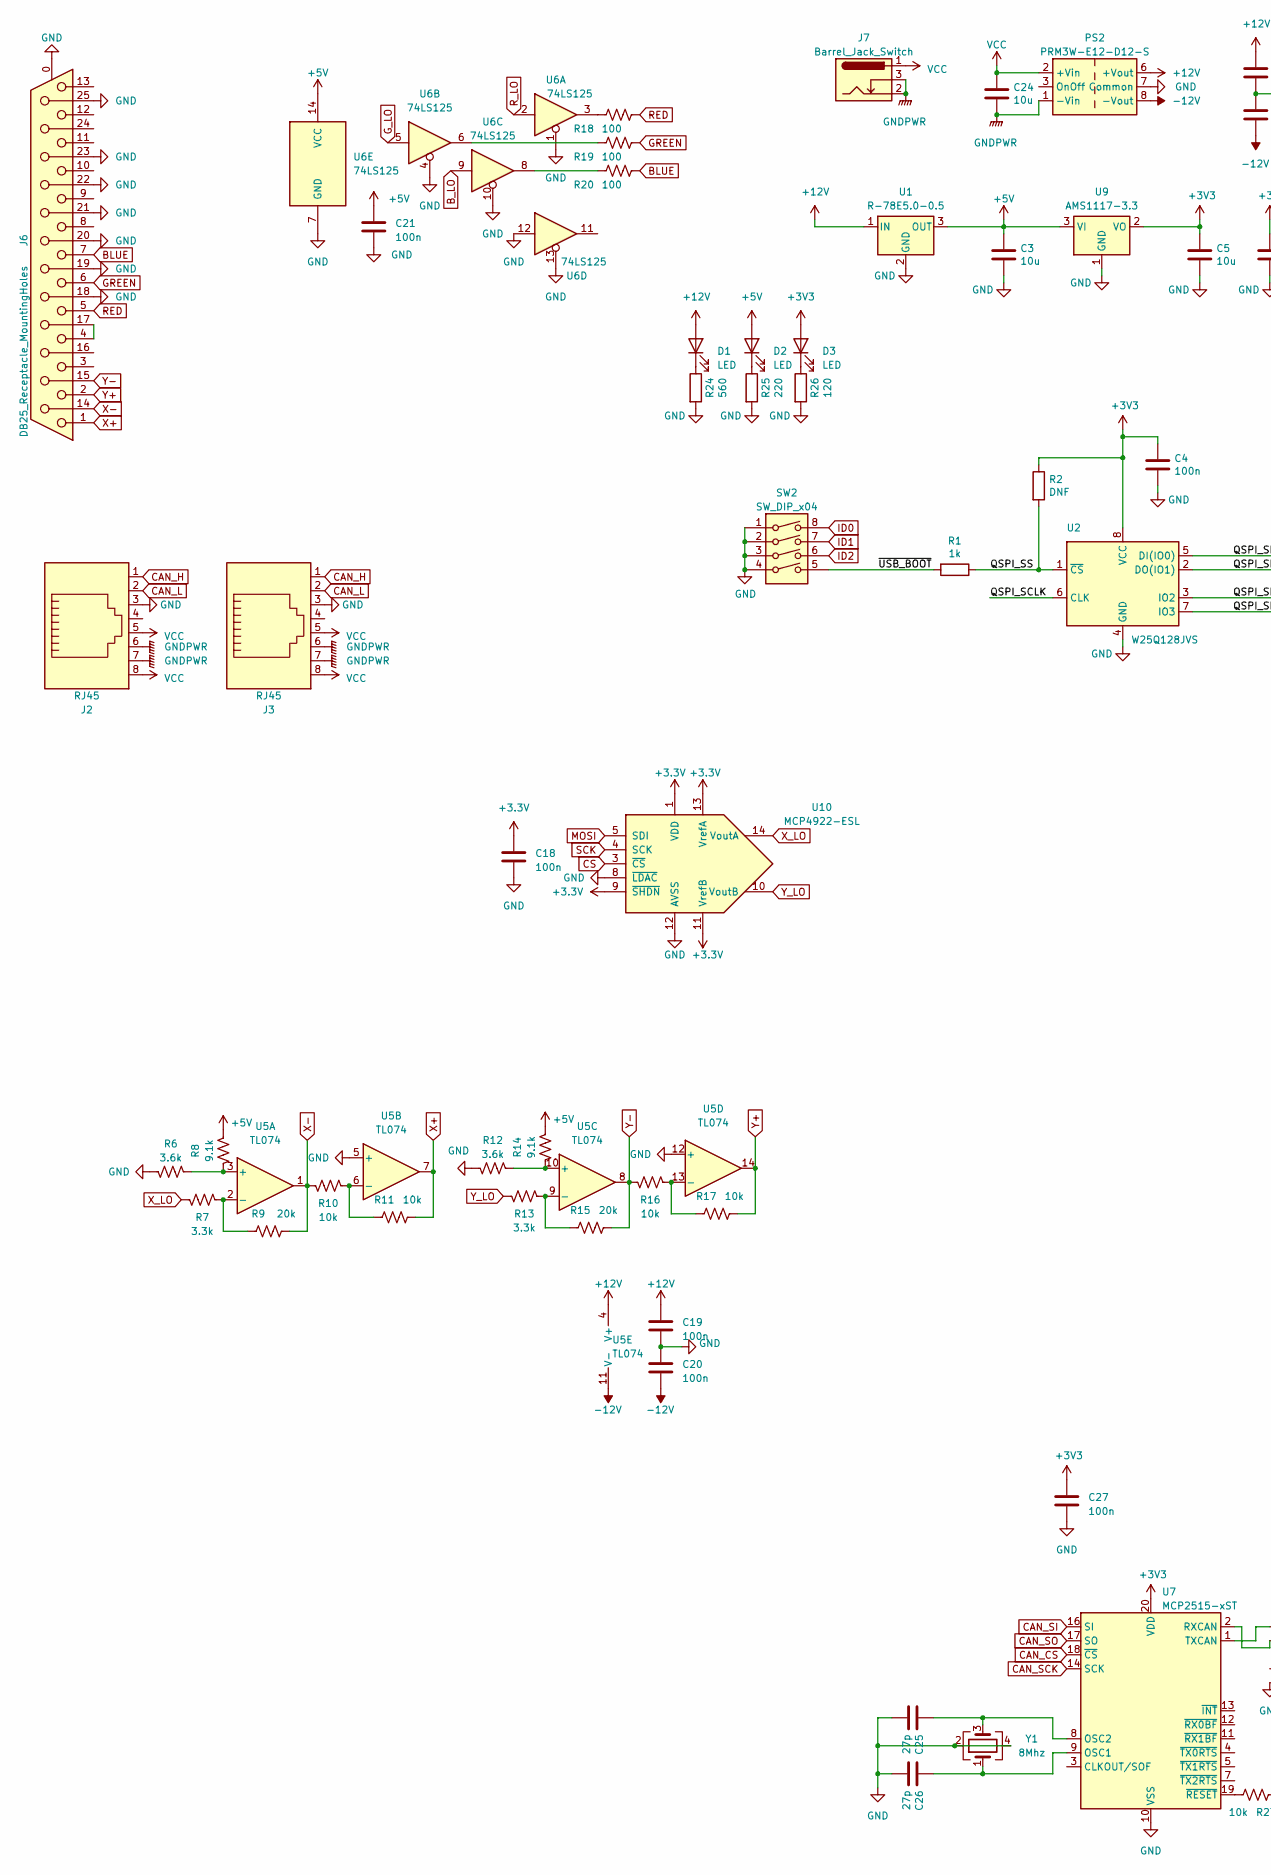
[picture p18: schematic canbus_adapter.kicad_sch, part in row 1, column 1]

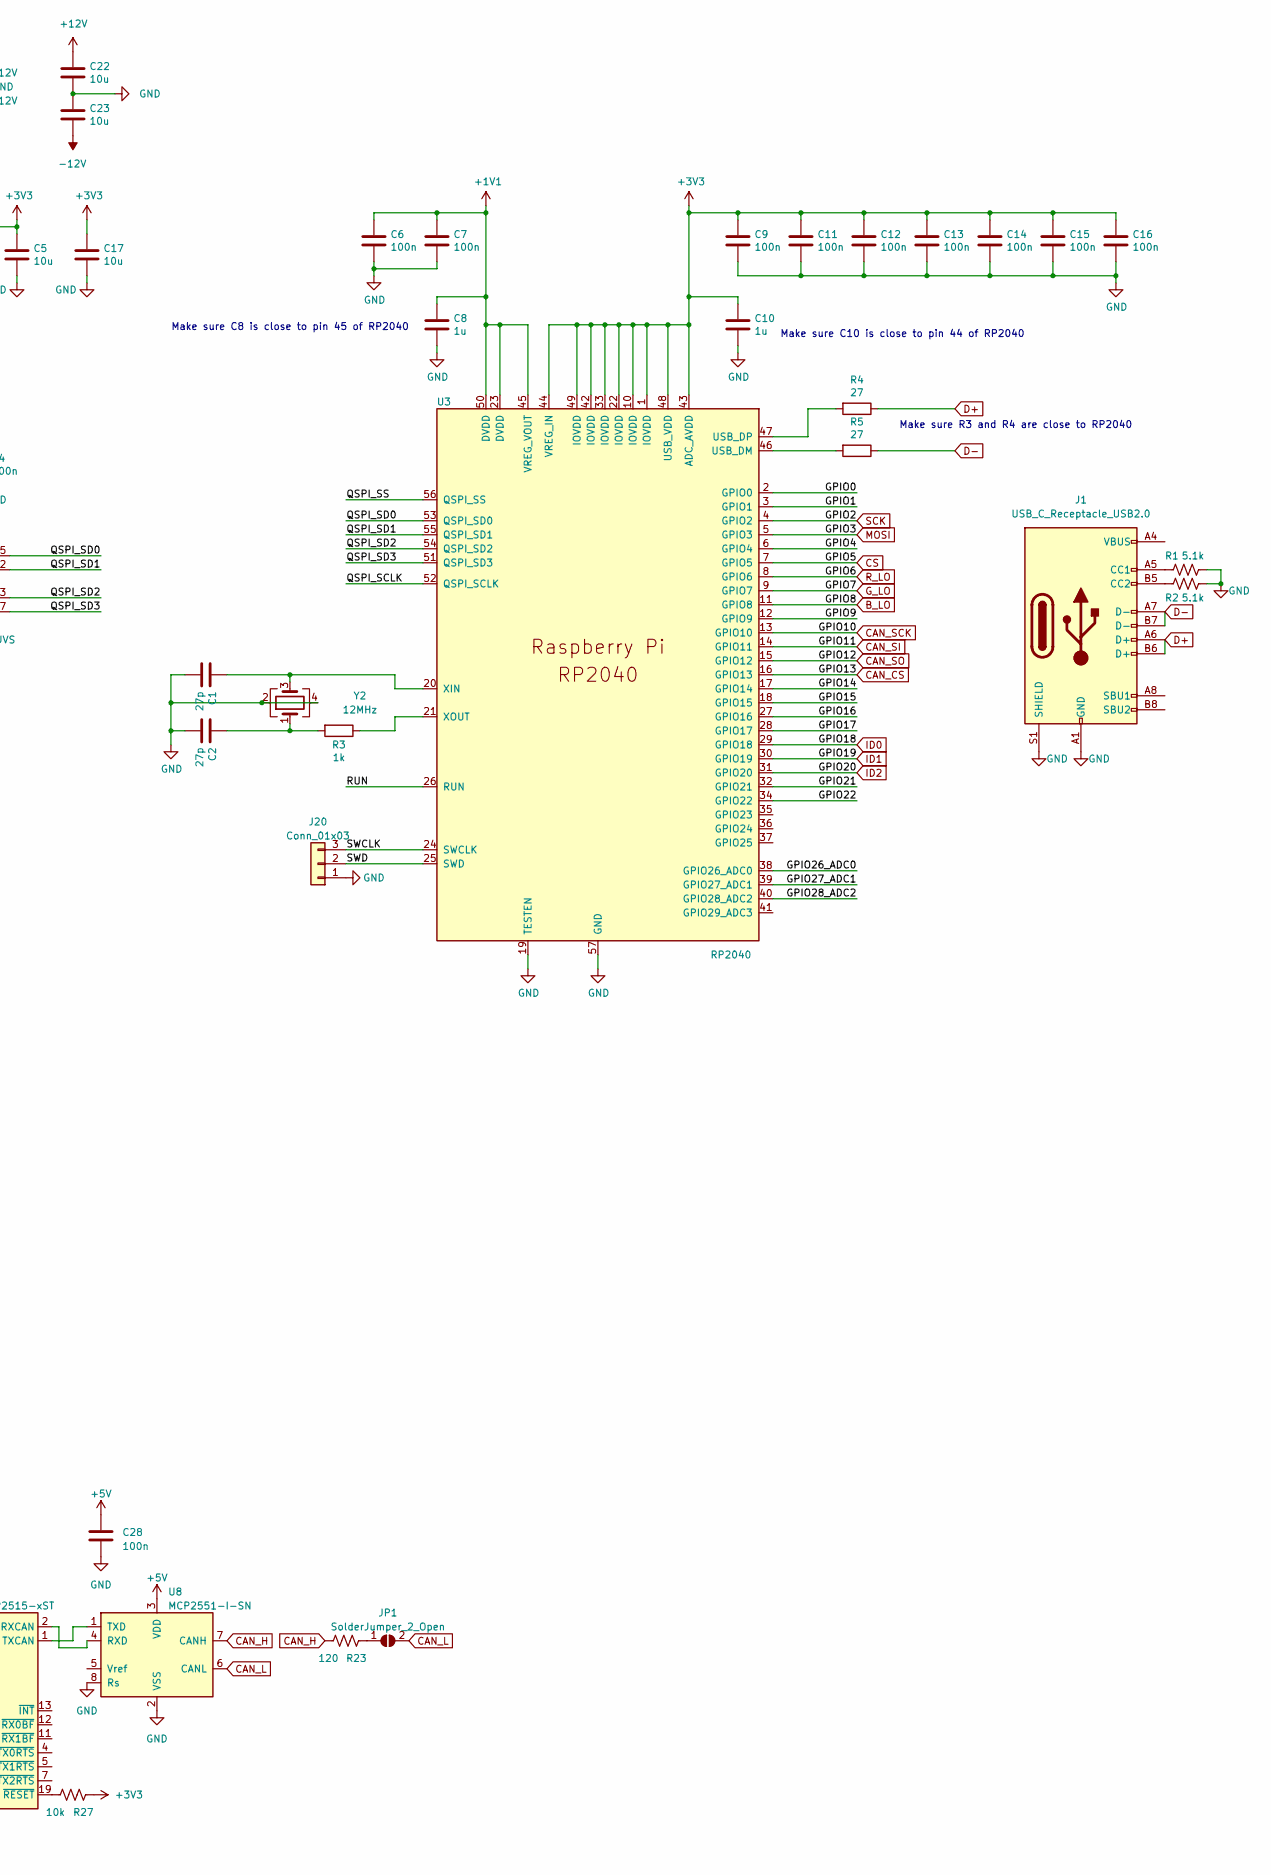
[picture p19: schematic canbus_adapter.kicad_sch, part in row 1, column 2]

Parts:
C1, C2, C25, C26: 27p; C_0603_1608Metric
C3, C5, C17, C22, C23, C24: 10u; C_0603_1608Metric
C4, C6, C7, C9, C11, C12, C13, C14, C15, C16, C18, C19, C20, C21, C27, C28: 100n; C_0603_1608Metric
C8, C10: 1u; C_0603_1608Metric
D1, D2, D3: LED; LED_0603_1608Metric
J1: USB_C_Receptacle_USB2.0; USB_C_Receptacle_Palconn_UTC16-G
J2, J3: RJ45; RJ45_Amphenol_54602-x08_Horizontal
J6: DB25_Receptacle_MountingHoles; DSUB-25_Female_Horizontal_P2.77x2.84mm_EdgePinOffset7.70mm_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
J7: Barrel_Jack_Switch; BarrelJack_CLIFF_FC681465S_SMT_Horizontal
J20: Conn_01x03; PinHeader_1x03_P2.54mm_Vertical
JP1: SolderJumper_2_Open; SolderJumper-2_P1.3mm_Open_RoundedPad1.0x1.5mm
PS2: PRM3W-E12-D12-S; Converter_DCDC_XP_POWER-ITxxxxxS_THT
R1: 5.1k; R_0603_1608Metric
R2: DNF; R_0603_1608Metric
R3: 1k; R_0603_1608Metric
R4, R5: 27; R_0603_1608Metric
R6, R12: 3.6k; R_0603_1608Metric
R7, R13: 3.3k; R_0603_1608Metric
R8, R14: 9.1k; R_0603_1608Metric
R9, R15: 20k; R_0603_1608Metric
R10, R11, R16, R17, R27: 10k; R_0603_1608Metric
R18, R19, R20: 100; R_0603_1608Metric
R23, R26: 120; R_0603_1608Metric
R24: 560; R_0603_1608Metric
R25: 220; R_0603_1608Metric
SW2: SW_DIP_x04; SW_DIP_SPSTx04_Slide_Omron_A6S-410x_W8.9mm_P2.54mm
U1: R-78E5.0-0.5; Converter_DCDC_RECOM_R-78E-0.5_THT
U2: W25Q128JVS; SOIC-8_5.23x5.23mm_P1.27mm
U3: RP2040; QFN-56-1EP_7x7mm_P0.4mm_EP3.2x3.2mm
U5: TL074; SOIC-14_3.9x8.7mm_P1.27mm
U6: 74LS125; SOIC-14_3.9x8.7mm_P1.27mm
U7: MCP2515-xST; TSSOP-20_4.4x6.5mm_P0.65mm
U8: MCP2551-I-SN; SOIC-8_3.9x4.9mm_P1.27mm
U9: AMS1117-3.3; SOT-223-3_TabPin2
U10: MCP4922-ESL; SOIC-14_3.9x8.7mm_P1.27mm
Y1: 8Mhz; Crystal_SMD_3225-4Pin_3.2x2.5mm
Y2: 12MHz; Crystal_SMD_3225-4Pin_3.2x2.5mm

Connections:
+1V1: C6.1, C7.1, C8.1, U3.23 (DVDD), U3.45 (VREG_VOUT), U3.50 (DVDD)
+5V: C3.1, C21.1, C28.1, D2.2 (A), R8.2, R14.2, U1.3 (OUT), U6.14 (VCC), U8.3 (VDD), U9.3 (VI)
+12V: C19.1, C22.1, D1.2 (A), PS2.6 (+Vout), U1.1 (IN), U5.4 (V+)
-12V: C20.2, C23.2, PS2.8 (-Vout), U5.11 (V-)
/GPIO0: U3.2 (GPIO0)
/GPIO1: U3.3 (GPIO1)
/GPIO4: U3.6 (GPIO4)
/GPIO9: U3.12 (GPIO9)
/GPIO14: U3.17 (GPIO14)
/GPIO15: U3.18 (GPIO15)
/GPIO16: U3.27 (GPIO16)
/GPIO17: U3.28 (GPIO17)
/GPIO21: U3.32 (GPIO21)
/GPIO22: U3.34 (GPIO22)
/GPIO26_ADC0: U3.38 (GPIO26_ADC0)
/GPIO27_ADC1: U3.39 (GPIO27_ADC1)
/GPIO28_ADC2: U3.40 (GPIO28_ADC2)
/QSPI_SCLK: U2.6 (CLK), U3.52 (QSPI_SCLK)
/QSPI_SD0: U2.5 (DI(IO0)), U3.53 (QSPI_SD0)
/QSPI_SD1: U2.2 (DO(IO1)), U3.55 (QSPI_SD1)
/QSPI_SD2: U2.3 (IO2), U3.54 (QSPI_SD2)
/QSPI_SD3: U2.7 (IO3), U3.51 (QSPI_SD3)
/RUN: U3.26 (RUN)
/SWCLK: U3.24 (SWCLK); also elsewhere on the board
/SWD: U3.25 (SWD); also elsewhere on the board
BLUE: J6.7, R20.2
B_LO: U3.11 (GPIO8), U6.9
CAN_CS: U3.16 (GPIO13), U7.18 (~CS)
CAN_H: J2.1, J3.1, R23.2, U8.7 (CANH)
CAN_L: J2.2, J3.2, JP1.2 (B), U8.6 (CANL)
CAN_SCK: U3.13 (GPIO10), U7.14 (SCK)
CAN_SI: U3.14 (GPIO11), U7.16 (SI)
CAN_SO: U3.15 (GPIO12), U7.17 (SO)
CS: U3.7 (GPIO5), U10.3 (~CS)
D+: J1.A6 (D+), J1.B6 (D+), R4.1
D-: J1.A7 (D-), J1.B7 (D-), R5.1
GNDPWR: C24.2, J2.6, J2.7, J3.6, J3.7, J7.2, J7.3, PS2.1 (-Vin)
GREEN: J6.6, R19.2
G_LO: U3.9 (GPIO7), U6.5
ID0: SW2.8, U3.29 (GPIO18)
ID1: SW2.7, U3.30 (GPIO19)
ID2: SW2.6, U3.31 (GPIO20)
MOSI: U3.5 (GPIO3), U10.5 (SDI)
unnamed: C2.1, R3.2, Y2.1
unnamed: D1.1 (K), R24.1
unnamed: D2.1 (K), R25.1
unnamed: D3.1 (K), R26.1
unnamed: J1.A4 (VBUS), J1.A9 (VBUS), J1.B4 (VBUS), J1.B9 (VBUS)
unnamed: J6.4, J6.17
unnamed: JP1.1 (A), R23.1
unnamed: R18.1, U6.3
unnamed: R19.1, U6.6
unnamed: R20.1, U6.8
unnamed: R5.2, U3.46 (USB_DM)
unnamed: R4.2, U3.47 (USB_DP)
unnamed: C1.1, U3.20 (XIN), Y2.3
unnamed: R3.1, U3.21 (XOUT)
unnamed: R6.2, R8.1, U5.3 (+)
unnamed: R7.2, R9.1, U5.2 (-)
unnamed: R10.2, R11.1, U5.6 (-)
unnamed: R12.2, R14.1, U5.10 (+)
unnamed: R13.2, R15.1, U5.9 (-)
unnamed: R16.2, R17.1, U5.13 (-)
unnamed: C26.1, U7.9 (OSC1), Y1.1
unnamed: C25.1, U7.8 (OSC2), Y1.3
unnamed: U7.2 (RXCAN), U8.4 (RXD)
unnamed: U7.1 (TXCAN), U8.1 (TXD)
unnamed: R27.2, U7.19 (~RESET)
RED: J6.5, R18.2
R_LO: U3.8 (GPIO6), U6.2
SCK: U3.4 (GPIO2), U10.4 (SCK)
VCC: C24.1, J2.5, J2.8, J3.5, J3.8, J7.1, PS2.2 (+Vin)
X+: J6.1, R11.2, U5.7
X-: J6.14, R9.2, R10.1, U5.1
X_LO: R7.1, U10.14 (VoutA)
Y+: J6.2, R17.2, U5.14
Y-: J6.15, R15.2, R16.1, U5.8
Y_LO: R13.1, U10.10 (VoutB)

Notes on the sheet:
Make sure C8 is close to pin 45 of RP2040
Make sure R3 and R4 are close to RP2040
Make sure C10 is close to pin 44 of RP2040

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
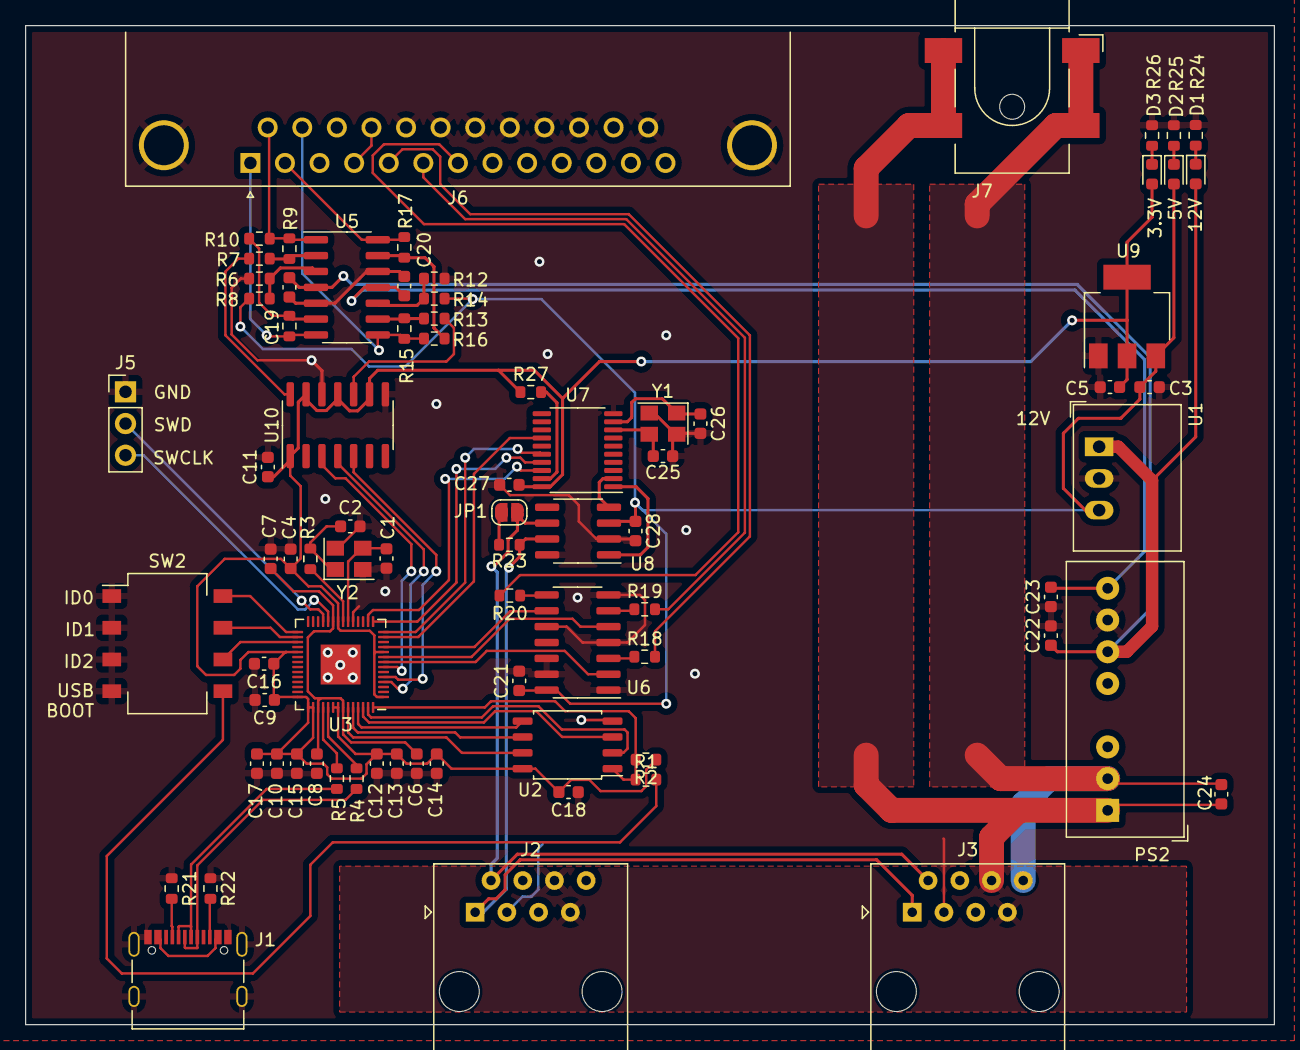
[picture p20: board canbus_adapter.kicad_pcb from above]

Board: 2 copper layers, 100.0 x 80.0 mm, 78 parts (0 on the bottom side), 70 nets.

Other parts of the board:
J5: Conn_01x03; PinHeader_1x03_P2.54mm_Vertical
R21, R22: 5.1k; R_0603_1608Metric

Their connections:
/SWCLK: J5.3; also elsewhere on the board
/SWD: J5.2; also elsewhere on the board
