adeboni/laser-projector/2023/hardware/4x_laser_controller/4x_laser_controller.kicad_pcb

## KiCad design 2023/hardware/4x_laser_controller/4x_laser_controller.kicad_pcb (2023-04-19)

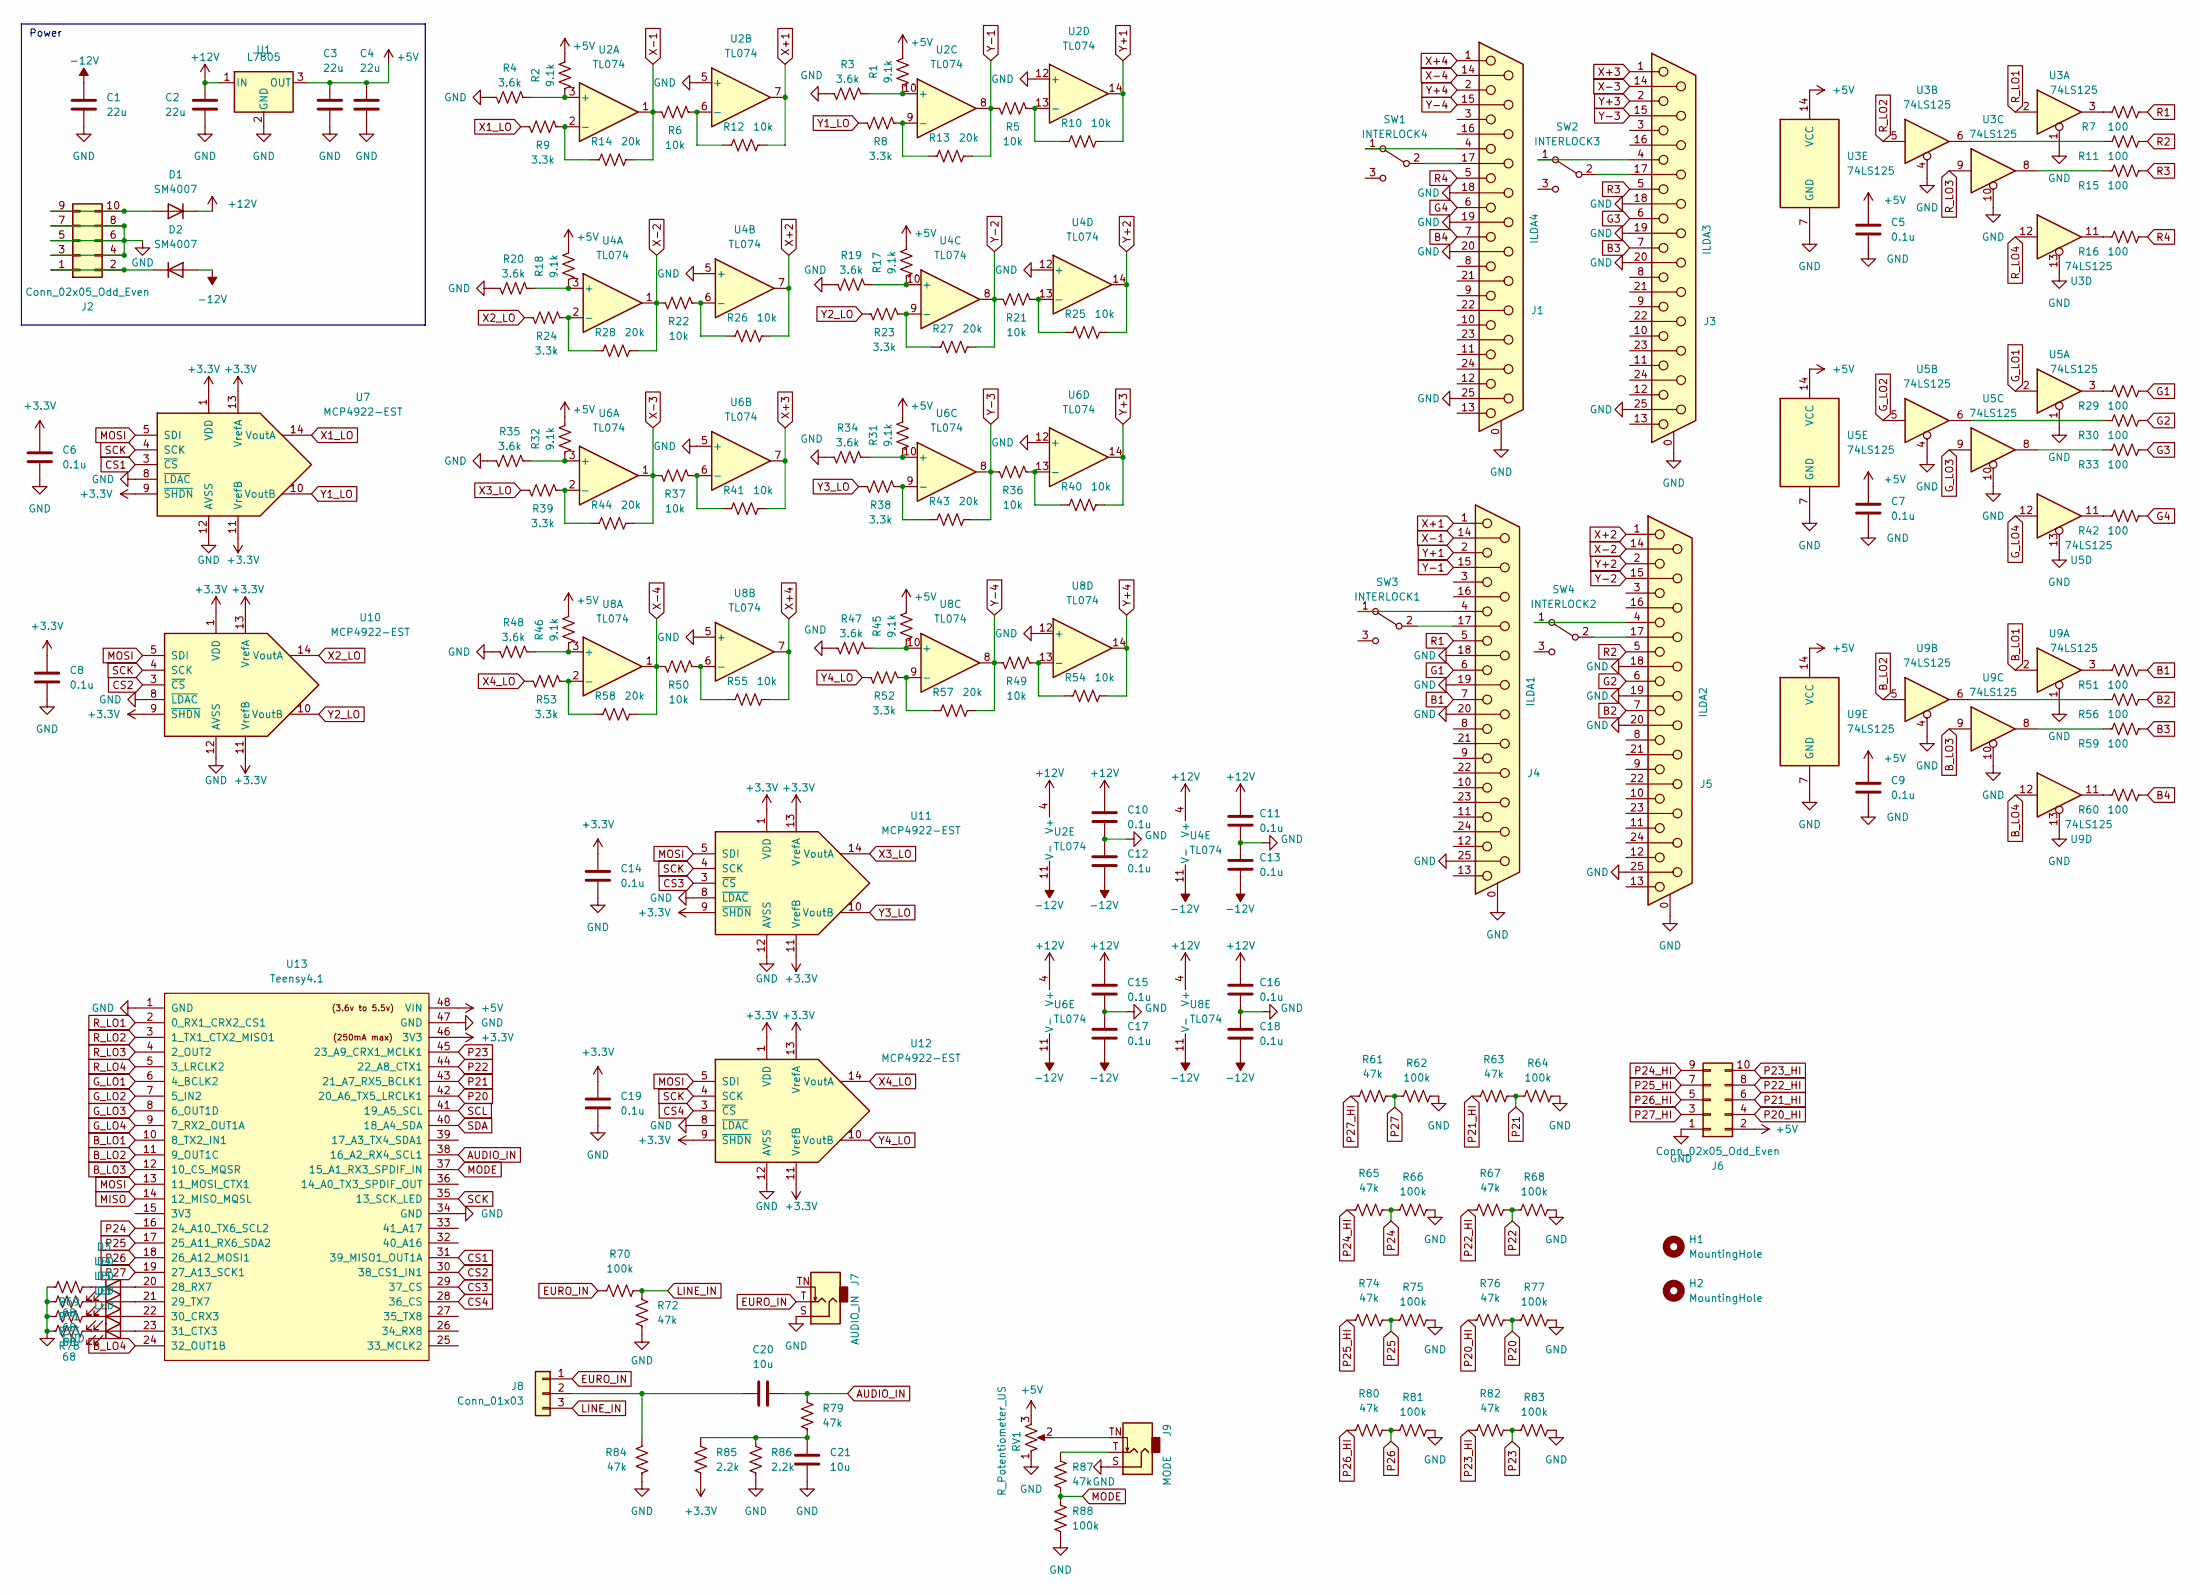
[picture p21: schematic 4x_laser_controller.kicad_sch]

Parts:
C1, C2, C3, C4: 22u; C_0805_2012Metric
C5, C6, C7, C8, C9, C10, C11, C12, C13, C14, C15, C16, C17, C18, C19: 0.1u; C_0603_1608Metric
C20, C21: 10u; C_0603_1608Metric
D1, D2: SM4007; D_SOD-123
D3, D4, D5, D6: LED; LED_D3.0mm
H1, H2: MountingHole; MountingHole_2.2mm_M2
J1: ILDA4; DSUB-25_Female_Vertical_P2.77x2.84mm_MountingHoles
J2, J6: Conn_02x05_Odd_Even; IDC-Header_2x05_P2.54mm_Vertical
J3: ILDA3; DSUB-25_Female_Vertical_P2.77x2.84mm_MountingHoles
J4: ILDA1; DSUB-25_Female_Vertical_P2.77x2.84mm_MountingHoles
J5: ILDA2; DSUB-25_Female_Vertical_P2.77x2.84mm_MountingHoles
J7: AUDIO_IN; Jack_3.5mm_QingPu_WQP-PJ398SM_Vertical_CircularHoles
J8: Conn_01x03; PinHeader_1x03_P2.54mm_Vertical
J9: MODE; Jack_3.5mm_QingPu_WQP-PJ398SM_Vertical_CircularHoles
R1, R2, R17, R18, R31, R32, R45, R46: 9.1k; R_0603_1608Metric
R3, R4, R19, R20, R34, R35, R47, R48: 3.6k; R_0603_1608Metric
R5, R6, R10, R12, R21, R22, R25, R26, R36, R37, R40, R41, R49, R50, R54, R55: 10k; R_0603_1608Metric
R7, R11, R15, R16, R29, R30, R33, R42, R51, R56, R59, R60: 100; R_0603_1608Metric
R8, R9, R23, R24, R38, R39, R52, R53: 3.3k; R_0603_1608Metric
R13, R14, R27, R28, R43, R44, R57, R58: 20k; R_0603_1608Metric
R61, R63, R65, R67, R72, R74, R76, R79, R80, R82, R84, R87: 47k; R_0603_1608Metric
R62, R64, R66, R68, R70, R75, R77, R81, R83, R88: 100k; R_0603_1608Metric
R69, R71, R73, R78: 68; R_0603_1608Metric
R85, R86: 2.2k; R_0603_1608Metric
RV1: R_Potentiometer_US; Potentiometer_Alpha_RD901F-40-00D_Single_Vertical
SW1: INTERLOCK4; Switch_Toggle_SPDT_Mini_SolderLug
SW2: INTERLOCK3; Switch_Toggle_SPDT_Mini_SolderLug
SW3: INTERLOCK1; Switch_Toggle_SPDT_Mini_SolderLug
SW4: INTERLOCK2; Switch_Toggle_SPDT_Mini_SolderLug
U1: L7805; TO-252-2
U2, U4, U6, U8: TL074; SOIC-14_3.9x8.7mm_P1.27mm
U3, U5, U9: 74LS125; SOIC-14_3.9x8.7mm_P1.27mm
U7, U10, U11, U12: MCP4922-EST; TSSOP-14_4.4x5mm_P0.65mm
U13: Teensy4.1; Teensy41

Connections:
+3V3: C6.2, C8.2, C14.2, C19.2, R85.1, U7.1 (VDD), U7.9 (~SHDN), U7.11 (VrefB), U7.13 (VrefA), U10.1 (VDD), U10.9 (~SHDN), U10.11 (VrefB), U10.13 (VrefA), U11.1 (VDD), U11.9 (~SHDN), U11.11 (VrefB), U11.13 (VrefA), U12.1 (VDD), U12.9 (~SHDN), U12.11 (VrefB), U12.13 (VrefA), U13.46 (3V3)
+5V: C3.1, C4.1, C5.1, C7.1, C9.1, J6.2, R1.2, R2.2, R17.2, R18.2, R31.2, R32.2, R45.2, R46.2, RV1.3, U1.3 (OUT), U3.14 (VCC), U5.14 (VCC), U9.14 (VCC), U13.48 (VIN)
+12V: C2.1, C10.1, C11.1, C15.1, C16.1, D1.1 (K), U1.1 (IN), U2.4 (V+), U4.4 (V+), U6.4 (V+), U8.4 (V+)
-12V: C1.1, C12.2, C13.2, C17.2, C18.2, D2.2 (A), U2.11 (V-), U4.11 (V-), U6.11 (V-), U8.11 (V-)
AUDIO_IN: C20.2, R79.2, U13.38 (16_A2_RX4_SCL1)
B1: J4.7, R51.2
B2: J5.7, R56.2
B3: J3.7, R59.2
B4: J1.7, R60.2
B_LO1: U9.2, U13.10 (8_TX2_IN1)
B_LO2: U9.5, U13.11 (9_OUT1C)
B_LO3: U9.9, U13.12 (10_CS_MQSR)
B_LO4: U9.12, U13.24 (32_OUT1B)
CS1: U7.3 (~CS), U13.31 (39_MISO1_OUT1A)
CS2: U10.3 (~CS), U13.30 (38_CS1_IN1)
CS3: U11.3 (~CS), U13.29 (37_CS)
CS4: U12.3 (~CS), U13.28 (36_CS)
EURO_IN: J7.T, J8.1, R70.1
G1: J4.6, R29.2
G2: J5.6, R30.2
G3: J3.6, R33.2
G4: J1.6, R42.2
GND: C1.2, C2.2, C3.2, C4.2, C5.2, C6.1, C7.2, C8.1, C9.2, C10.2, C11.2, C12.1, C13.1, C14.1, C15.2, C16.2, C17.1, C18.1, C19.1, C21.1, J1.0 (PAD), J1.18, J1.19, J1.20, J1.25, J2.3, J2.4, J2.5, J2.6, J2.7, J2.8, J3.0 (PAD), J3.18, J3.19, J3.20, J3.25, J4.0 (PAD), J4.18, J4.19, J4.20, J4.25, J5.0 (PAD), J5.18, J5.19, J5.20, J5.25, J6.1, J7.S, J9.S, R3.1, R4.1, R19.1, R20.1, R34.1, R35.1, R47.1, R48.1, R62.1, R64.1, R66.1, R68.1, R69.1, R71.1, R72.1, R73.1, R75.1, R77.1, R78.1, R81.1, R83.1, R84.1, R86.1, R88.2, RV1.1, U1.2 (GND), U2.5 (+), U2.12 (+), U3.1, U3.4, U3.7 (GND), U3.10, U3.13, U4.5 (+), U4.12 (+), U5.1, U5.4, U5.7 (GND), U5.10, U5.13, U6.5 (+), U6.12 (+), U7.8 (~LDAC), U7.12 (AVSS), U8.5 (+), U8.12 (+), U9.1, U9.4, U9.7 (GND), U9.10, U9.13, U10.8 (~LDAC), U10.12 (AVSS), U11.8 (~LDAC), U11.12 (AVSS), U12.8 (~LDAC), U12.12 (AVSS), U13.1 (GND), U13.34 (GND), U13.47 (GND)
G_LO1: U5.2, U13.6 (4_BCLK2)
G_LO2: U5.5, U13.7 (5_IN2)
G_LO3: U5.9, U13.8 (6_OUT1D)
G_LO4: U5.12, U13.9 (7_RX2_OUT1A)
LINE_IN: J8.3, R70.2, R72.2
MISO: U13.14 (12_MISO_MQSL)
MODE: R87.1, R88.1, U13.37 (15_A1_RX3_SPDIF_IN)
MOSI: U7.5 (SDI), U10.5 (SDI), U11.5 (SDI), U12.5 (SDI), U13.13 (11_MOSI_CTX1)
unnamed: C20.1, J8.2, R84.2
unnamed: C21.2, R79.1, R85.2, R86.2
unnamed: D1.2 (A), J2.9, J2.10
unnamed: D2.1 (K), J2.1, J2.2
unnamed: D3.1 (K), R69.2
unnamed: D3.2 (A), U13.20 (28_RX7)
unnamed: D4.1 (K), R71.2
unnamed: D4.2 (A), U13.21 (29_TX7)
unnamed: D5.1 (K), R73.2
unnamed: D5.2 (A), U13.22 (30_CRX3)
unnamed: D6.1 (K), R78.2
unnamed: D6.2 (A), U13.23 (31_CTX3)
unnamed: J1.4, SW1.1 (A)
unnamed: J1.17, SW1.2 (B)
unnamed: J3.4, SW2.1 (A)
unnamed: J3.17, SW2.2 (B)
unnamed: J4.4, SW3.1 (A)
unnamed: J4.17, SW3.2 (B)
unnamed: J5.4, SW4.1 (A)
unnamed: J5.17, SW4.2 (B)
unnamed: J9.T, R87.2
unnamed: J9.TN, RV1.2
unnamed: R1.1, R3.2, U2.10 (+)
unnamed: R2.1, R4.2, U2.3 (+)
unnamed: R7.1, U3.3
unnamed: R5.2, R10.1, U2.13 (-)
unnamed: R11.1, U3.6
unnamed: R6.2, R12.1, U2.6 (-)
unnamed: R8.2, R13.1, U2.9 (-)
unnamed: R9.2, R14.1, U2.2 (-)
unnamed: R15.1, U3.8
unnamed: R16.1, U3.11
unnamed: R17.1, R19.2, U4.10 (+)
unnamed: R18.1, R20.2, U4.3 (+)
unnamed: R21.2, R25.1, U4.13 (-)
unnamed: R22.2, R26.1, U4.6 (-)
unnamed: R23.2, R27.1, U4.9 (-)
unnamed: R24.2, R28.1, U4.2 (-)
unnamed: R29.1, U5.3
unnamed: R30.1, U5.6
unnamed: R31.1, R34.2, U6.10 (+)
unnamed: R32.1, R35.2, U6.3 (+)
unnamed: R33.1, U5.8
unnamed: R36.2, R40.1, U6.13 (-)
unnamed: R37.2, R41.1, U6.6 (-)
unnamed: R38.2, R43.1, U6.9 (-)
unnamed: R39.2, R44.1, U6.2 (-)
unnamed: R42.1, U5.11
unnamed: R45.1, R47.2, U8.10 (+)
unnamed: R46.1, R48.2, U8.3 (+)
unnamed: R49.2, R54.1, U8.13 (-)
unnamed: R50.2, R55.1, U8.6 (-)
unnamed: R51.1, U9.3
unnamed: R52.2, R57.1, U8.9 (-)
unnamed: R53.2, R58.1, U8.2 (-)
unnamed: R56.1, U9.6
unnamed: R59.1, U9.8
unnamed: R60.1, U9.11
P20: R76.2, R77.2, U13.42 (20_A6_TX5_LRCLK1)
P20_HI: J6.4, R76.1
P21: R63.2, R64.2, U13.43 (21_A7_RX5_BCLK1)
P21_HI: J6.6, R63.1
P22: R67.2, R68.2, U13.44 (22_A8_CTX1)
P22_HI: J6.8, R67.1
P23: R82.2, R83.2, U13.45 (23_A9_CRX1_MCLK1)
P23_HI: J6.10, R82.1
P24: R65.2, R66.2, U13.16 (24_A10_TX6_SCL2)
P24_HI: J6.9, R65.1
P25: R74.2, R75.2, U13.17 (25_A11_RX6_SDA2)
P25_HI: J6.7, R74.1
P26: R80.2, R81.2, U13.18 (26_A12_MOSI1)
P26_HI: J6.5, R80.1
P27: R61.2, R62.2, U13.19 (27_A13_SCK1)
P27_HI: J6.3, R61.1
R1: J4.5, R7.2
R2: J5.5, R11.2
R3: J3.5, R15.2
R4: J1.5, R16.2
R_LO1: U3.2, U13.2 (0_RX1_CRX2_CS1)
R_LO2: U3.5, U13.3 (1_TX1_CTX2_MISO1)
R_LO3: U3.9, U13.4 (2_OUT2)
R_LO4: U3.12, U13.5 (3_LRCLK2)
SCK: U7.4 (SCK), U10.4 (SCK), U11.4 (SCK), U12.4 (SCK), U13.35 (13_SCK_LED)
SCL: U13.41 (19_A5_SCL)
SDA: U13.40 (18_A4_SDA)
X1_LO: R9.1, U7.14 (VoutA)
X2_LO: R24.1, U10.14 (VoutA)
X3_LO: R39.1, U11.14 (VoutA)
X4_LO: R53.1, U12.14 (VoutA)
X+1: J4.1, R12.2, U2.7
X+2: J5.1, R26.2, U4.7
X+3: J3.1, R41.2, U6.7
X+4: J1.1, R55.2, U8.7
X-1: J4.14, R6.1, R14.2, U2.1
X-2: J5.14, R22.1, R28.2, U4.1
X-3: J3.14, R37.1, R44.2, U6.1
X-4: J1.14, R50.1, R58.2, U8.1
Y1_LO: R8.1, U7.10 (VoutB)
Y2_LO: R23.1, U10.10 (VoutB)
Y3_LO: R38.1, U11.10 (VoutB)
Y4_LO: R52.1, U12.10 (VoutB)
Y+1: J4.2, R10.2, U2.14
Y+2: J5.2, R25.2, U4.14
Y+3: J3.2, R40.2, U6.14
Y+4: J1.2, R54.2, U8.14
Y-1: J4.15, R5.1, R13.2, U2.8
Y-2: J5.15, R21.1, R27.2, U4.8
Y-3: J3.15, R36.1, R43.2, U6.8
Y-4: J1.15, R49.1, R57.2, U8.8

Notes on the sheet:
Power

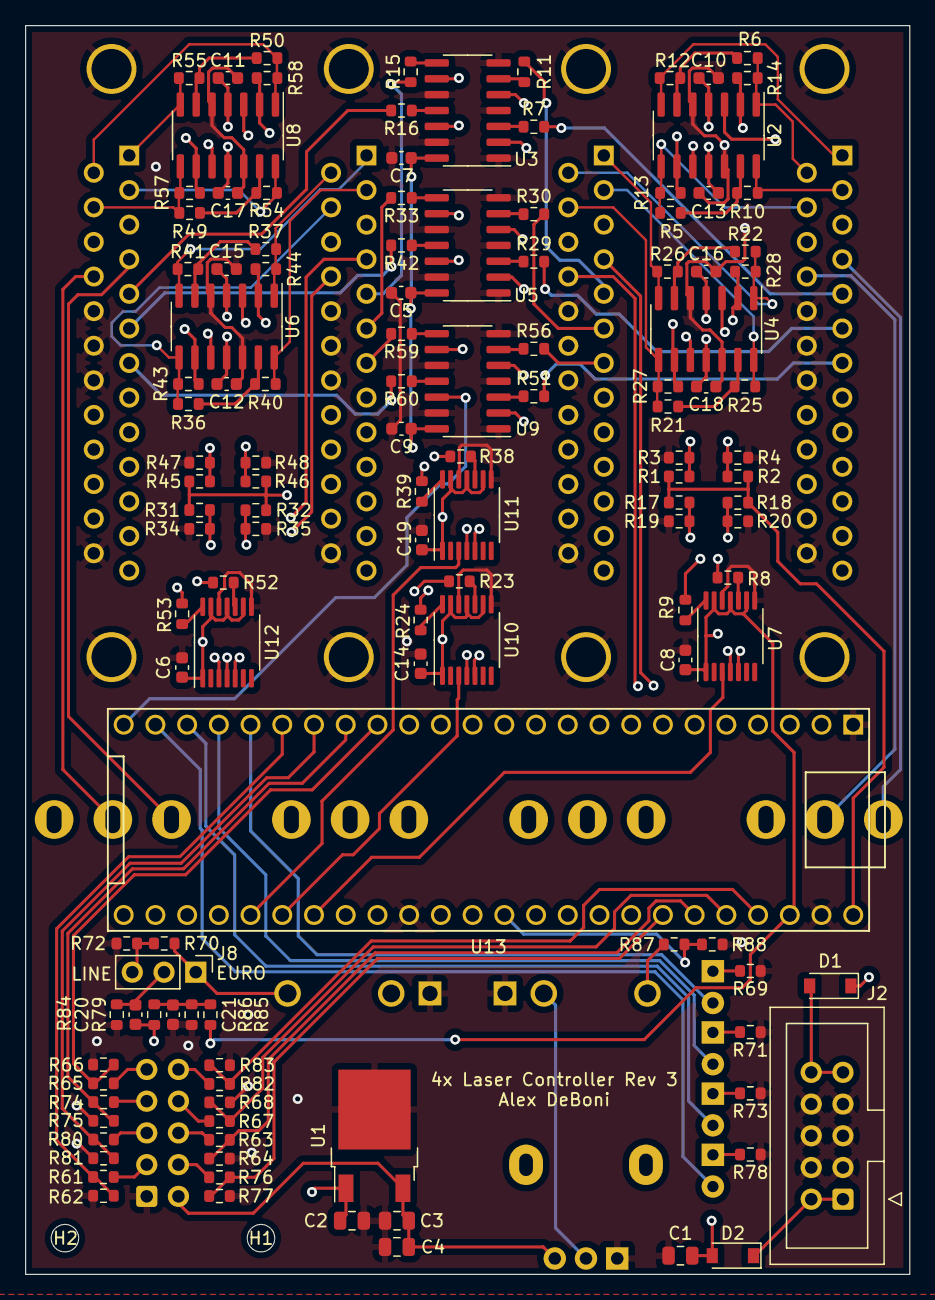
[picture p22: board 4x_laser_controller.kicad_pcb from above]

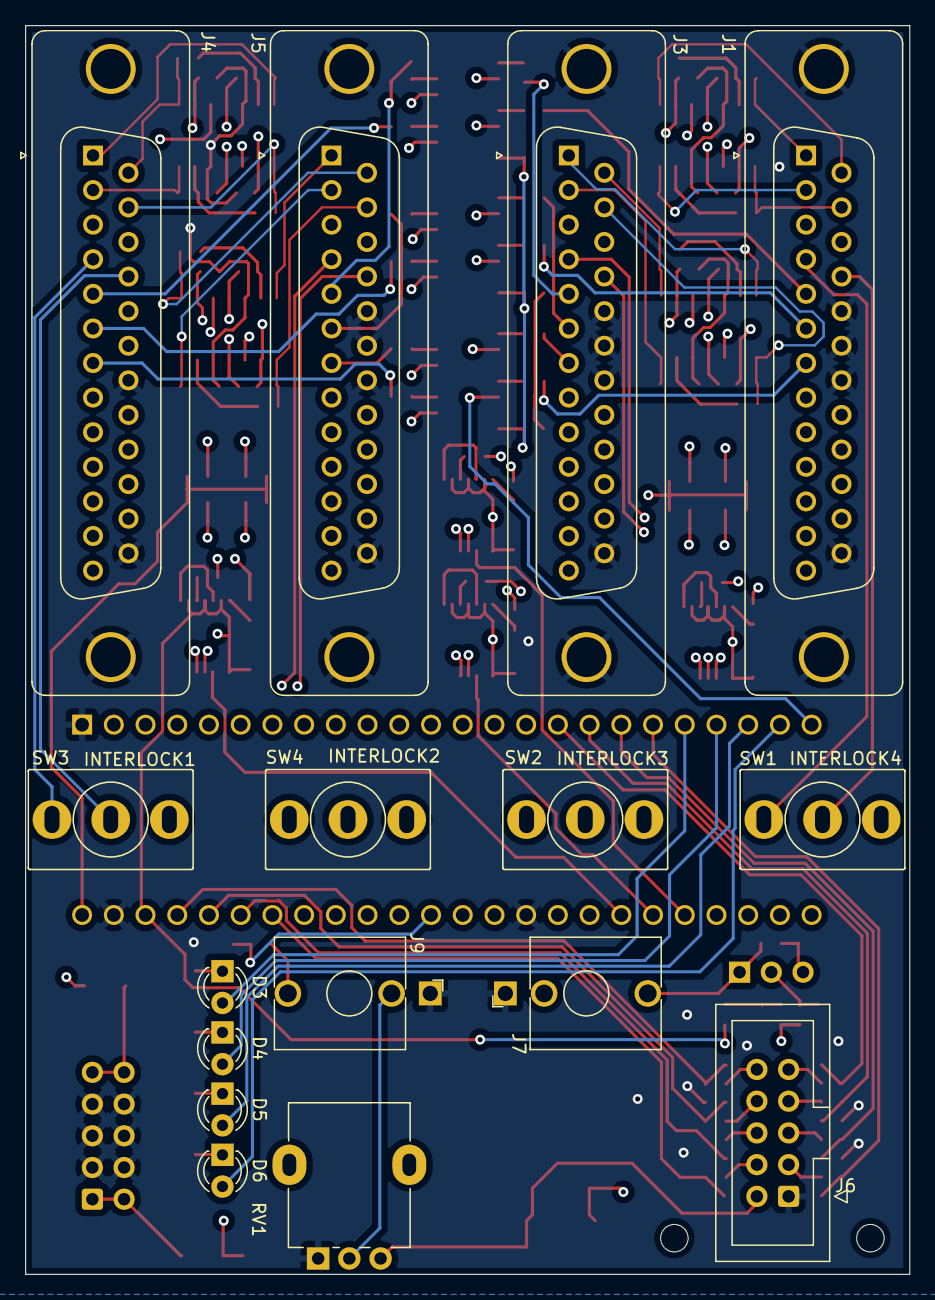
[picture p23: board 4x_laser_controller.kicad_pcb from below]

Board: 4 copper layers, 70.8 x 100.0 mm, 144 parts (16 on the bottom side), 137 nets.
