adeboni/laser-projector/2023/hardware/mega_laser_driver/mega_laser_driver.kicad_pcb

## KiCad design 2023/hardware/mega_laser_driver/mega_laser_driver.kicad_pcb (2023-11-15)

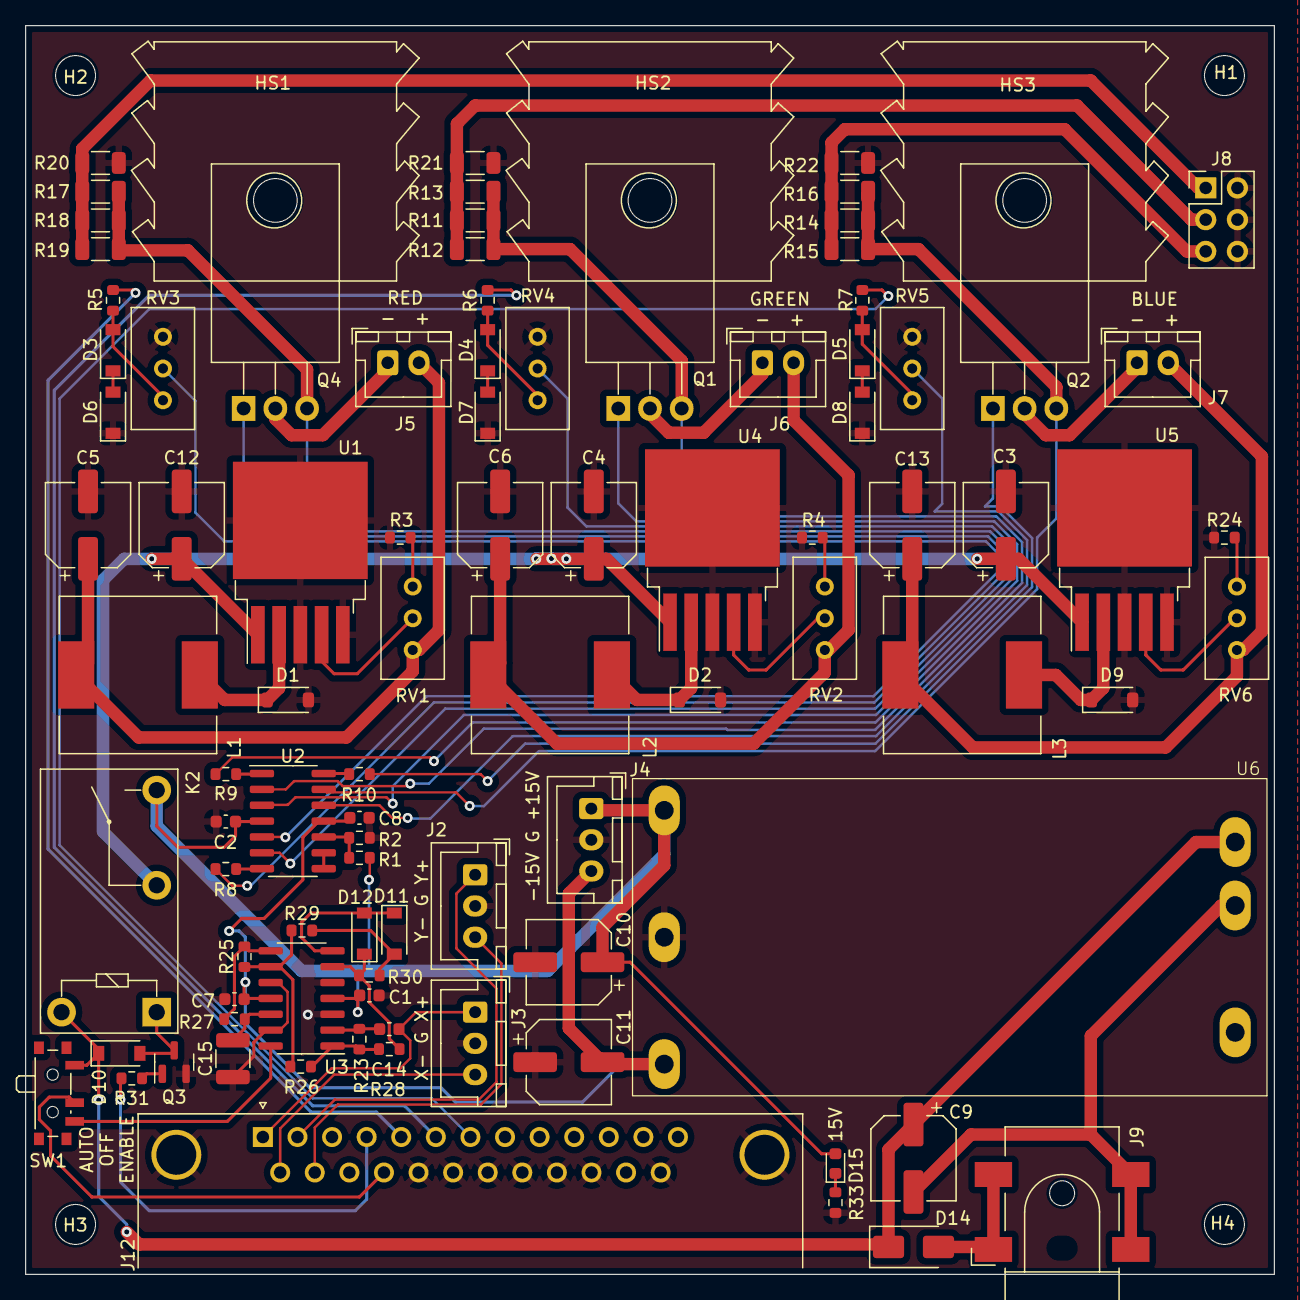
[picture p24: board mega_laser_driver.kicad_pcb from above]

Board: 2 copper layers, 100.0 x 100.0 mm, 98 parts (0 on the bottom side), 66 nets.

Parts:
C1, C2, C7, C8: 100n; C_0603_1608Metric
C3, C4, C5, C6, C9, C10, C11, C12, C13: 220u; CP_Elec_6.3x7.7
C14: 2u; C_0603_1608Metric
C15: 47u; C_1210_3225Metric
D1, D2, D9: 1N5819WS; D_SOD-123
D3, D4, D5, D6, D7, D8, D10, D11, D12: 1N4148W; D_SOD-123
D14: SS54; D_SMA
D15: LED; LED_0603_1608Metric
H1, H2, H3, H4: MountingHole; MountingHole_3.2mm_M3
HS1, HS2, HS3: Heatsink; Heatsink_AAVID_TV5G_TO220_Horizontal
J2, J3, J4: Conn_01x03; JST_XH_B3B-XH-A_1x03_P2.50mm_Vertical
J5, J6, J7: Conn_01x02; JST_XH_B2B-XH-A_1x02_P2.50mm_Vertical
J8: Conn_02x03_Odd_Even; PinHeader_2x03_P2.54mm_Vertical
J9: Barrel_Jack_Switch; BarrelJack_CLIFF_FC681465S_SMT_Horizontal
J12: DB25_Plug_MountingHoles; DSUB-25_Male_Horizontal_P2.77x2.84mm_EdgePinOffset7.70mm_Ho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
K2: G5Q-1A-DC12; Relay_SPST_Omron-G5Q-1A
L1, L2, L3: 150uH; L_12x12mm_H8mm
Q1, Q2, Q4: TIP120; TO-220-3_Horizontal_TabDown
Q3: 2N7002; SOT-23
R1, R2: 10k; R_0603_1608Metric
R3, R4, R24: 1.2k; R_0603_1608Metric
R5, R6, R7: 33k; R_0603_1608Metric
R8, R9, R10, R31: 100; R_0603_1608Metric
R11, R12, R13, R14, R15, R16, R17, R18, R19, R20, R21, R22: 10R; R_1206_3216Metric
R23: 5k; R_0603_1608Metric
R25, R26, R27, R28, R30: 1k; R_0603_1608Metric
R29: 500; R_0603_1608Metric
R33: 680; R_0603_1608Metric
RV1, RV2, RV3, RV4, RV5, RV6: 10k; Potentiometer_Bourns_3296W_Vertical
SW1: SW_SPDT; SW_SPDT_PCM12
U1, U4, U5: LM2576S-ADJ; TO-263-5_TabPin3
U2, U3: LM324; SOIC-14_3.9x8.7mm_P1.27mm
U6: TEN20-2422WIN; PYBE30-Q24-D15

Connections:
+12V: C9.1, D10.1 (K), D14.1 (K), K2.5, SW1.1 (A), U6.1 (VIN+)
+15V: C1.1, C2.1, C10.1, D15.2 (A), J4.1, K2.3, R1.2, U2.4 (V+), U3.4 (V+), U6.6 (VOUT+)
-15V: C7.1, C8.1, C11.2, J4.3, U2.11 (V-), U3.11 (V-), U6.4 (VOUT-)
BLUE: J12.7, R7.2
GND: C1.2, C2.2, C3.2, C4.2, C5.2, C6.2, C7.2, C8.2, C10.2, C11.1, C12.2, C13.2, C15.1, D1.2 (A), D2.2 (A), D6.1 (K), D7.1 (K), D8.1 (K), D9.2 (A), J2.2, J3.2, J4.2, J8.2, J8.4, J8.6, J12.0 (PAD), J12.18, J12.19, J12.20, J12.21, J12.22, J12.23, J12.25, Q3.2 (S), R2.1, R3.1, R4.1, R20.2, R21.2, R22.2, R24.1, R33.2, RV3.3, RV4.3, RV5.3, U1.3 (GND), U1.5 (~ON/OFF), U3.3 (+), U3.5 (+), U3.10 (+), U3.13 (-), U4.3 (GND), U4.5 (~ON/OFF), U5.3 (GND), U5.5 (~ON/OFF), U6.5 (CM)
GREEN: J12.6, R6.2
INTERLOCK1: J12.4, R31.1
INTERLOCK2: J12.17, SW1.2 (B)
MOTOR_ON: SW1.3 (C), U3.14
unnamed: D1.1 (K), L1.1, U1.2 (OUT)
unnamed: D2.1 (K), L2.1, U4.2 (OUT)
unnamed: D3.2 (A), R5.1, RV3.1
unnamed: D3.1 (K), D6.2 (A)
unnamed: D4.2 (A), R6.1, RV4.1
unnamed: D4.1 (K), D7.2 (A)
unnamed: D5.2 (A), R7.1, RV5.1
unnamed: D5.1 (K), D8.2 (A)
unnamed: D9.1 (K), L3.1, U5.2 (OUT)
unnamed: D10.2 (A), K2.1, Q3.3 (D)
unnamed: D11.2 (A), R29.1, R30.1
unnamed: D11.1 (K), D12.2 (A), U3.7
unnamed: D12.1 (K), R28.2, R30.2, U3.6 (-)
unnamed: D14.2 (A), J9.1
unnamed: D15.1 (K), R33.1
unnamed: J5.1, Q4.2 (C)
unnamed: J6.1, Q1.2 (C)
unnamed: J7.1, Q2.2 (C)
unnamed: J8.1, R17.2, R18.2, R19.2, R20.1
unnamed: J8.3, R11.2, R12.2, R13.2, R21.1
unnamed: J8.5, R14.2, R15.2, R16.2, R22.1
unnamed: Q1.1 (B), R9.2
unnamed: Q1.3 (E), R11.1, R12.1, R13.1, U2.2 (-)
unnamed: Q2.1 (B), R10.2
unnamed: Q2.3 (E), R14.1, R15.1, R16.1, U2.13 (-)
unnamed: Q3.1 (G), R31.2
unnamed: Q4.1 (B), R8.2
unnamed: Q4.3 (E), R17.1, R18.1, R19.1, U2.6 (-)
unnamed: R3.2, RV1.3
unnamed: R4.2, RV2.3
unnamed: R8.1, U2.7
unnamed: R9.1, U2.1
unnamed: R10.1, U2.14
unnamed: R23.2, R26.1, R28.1, U3.1
unnamed: R24.2, RV6.3
unnamed: R25.2, R27.1, U3.8
unnamed: RV1.2, U1.4 (FB)
unnamed: RV4.2, U2.3 (+)
unnamed: RV3.2, U2.5 (+)
unnamed: R1.1, R2.2, U2.10 (+)
unnamed: U2.8, U2.9 (-)
unnamed: RV5.2, U2.12 (+)
unnamed: C14.2, R23.1, U3.2 (-)
unnamed: R25.1, R26.2, R29.2, U3.9 (-)
unnamed: C15.2, R27.2, U3.12 (+)
unnamed: RV2.2, U4.4 (FB)
unnamed: RV6.2, U5.4 (FB)
unnamed: C9.2, J9.2, J9.3, U6.2 (VIN-)
RED: J12.5, R5.2
V1: C5.1, J5.2, L1.2, RV1.1
V2: C6.1, J6.2, L2.2, RV2.1
V3: C13.1, J7.2, L3.2, RV6.1
VCC: C3.1, C4.1, C12.1, K2.2, U1.1 (VIN), U4.1 (VIN), U5.1 (VIN)
X+: C14.1, J3.1, J12.1
X-: J3.3, J12.14
Y+: J2.1, J12.2
Y-: J2.3, J12.15
