adeboni/laser-projector/2023/hardware/15v_power/15v_power.kicad_pcb

## KiCad design 2023/hardware/15v_power/15v_power.kicad_pcb (2022-12-08)

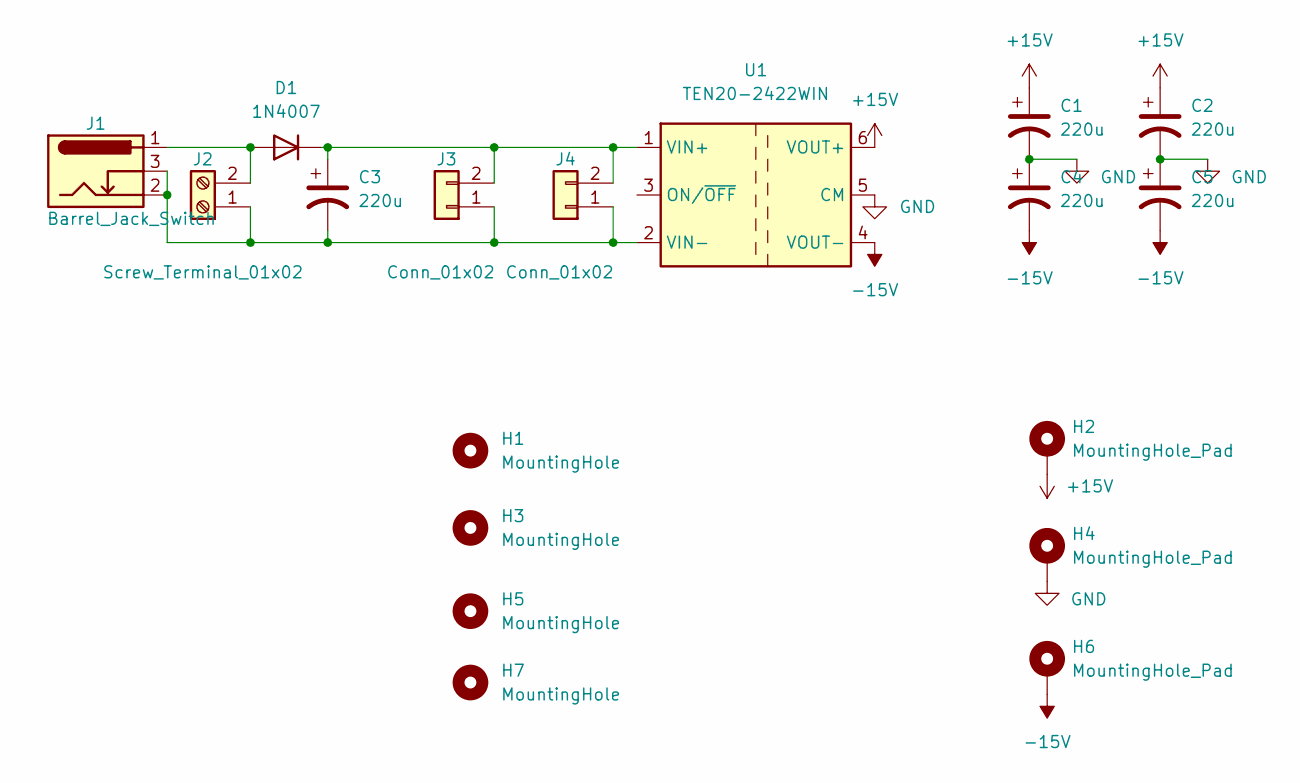
[picture p25: schematic 15v_power.kicad_sch]

Parts:
C1, C2, C3, C4, C5: 220u; CP_Radial_D10.0mm_P5.00mm
D1: 1N4007; D_DO-41_SOD81_P10.16mm_Horizontal
H1, H3, H5, H7: MountingHole; MountingHole_3.2mm_M3
H2, H4, H6: MountingHole_Pad; MountingHole_3.2mm_M3_ISO7380_Pad_TopBottom
J1: Barrel_Jack_Switch; BarrelJack_Horizontal
J2: Screw_Terminal_01x02; TerminalBlock_Phoenix_MKDS-1,5-2_1x02_P5.00mm_Horizontal
J3, J4: Conn_01x02; JST_XH_B2B-XH-A_1x02_P2.50mm_Vertical
U1: TEN20-2422WIN; CONV_PYBE30-Q24-D12

Connections:
+15V: C1.1, C2.1, H2.1, U1.6 (VOUT+)
-15V: C4.2, C5.2, H6.1, U1.4 (VOUT-)
GND: C1.2, C2.2, C4.1, C5.1, H4.1, U1.5 (CM)
unnamed: C3.1, D1.1 (K), J3.2, J4.2, U1.1 (VIN+)
unnamed: C3.2, J1.2, J1.3, J2.1, J3.1, J4.1, U1.2 (VIN-)
unnamed: D1.2 (A), J1.1, J2.2

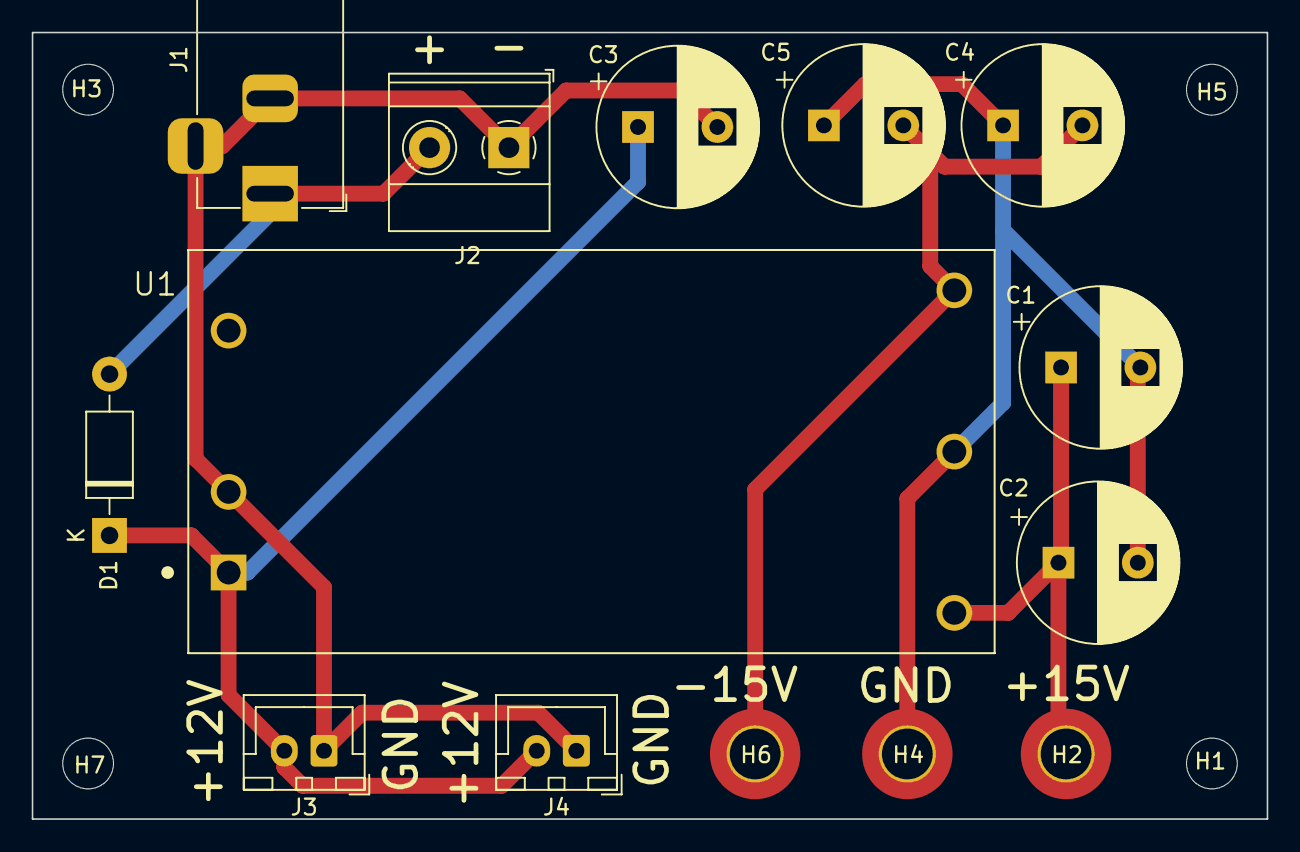
[picture p26: board 15v_power.kicad_pcb from above]

Board: 2 copper layers, 77.8 x 49.5 mm, 18 parts (0 on the bottom side), 6 nets.
