adeboni/laser-projector/2023/software/laser_controller/Drawing.h

#ifndef DRAWING_H
#define DRAWING_H

#include "Laser.h"

extern Laser lasers[4];

class Drawing {
public:
  static void drawString(String text, int x, int y, float scale = 1);
  static long drawLetter(byte letter, int translateX = 0, int translateY = 0, float scale = 1);
  static long advance(byte letter, float scale = 1);
  static long stringAdvance(String text, float scale = 1);
  static void drawObject(const unsigned short* data, int size, int translateX = 0, int translateY = 0, float scale = 1);
  static void drawObjectRotated3D(const unsigned short* data, int size, int centerX, int centerY, Vector3 rotation);
  static void calcObjectBox(const unsigned short* data, int size, int& centerX, int& centerY, int& width, int& height);
};

#endif
