adeboni/laser-projector/(commit log)

2022-12-08 initial working prototype
    [cube.stl]
2022-12-08 Added hardware and re-organized files
    [4x_laser_controller.kicad_pcb, 4x_laser_controller.kicad_sch, 4x_laser_controller_fp.kicad_pcb, 4x_laser_controller_fp.kicad_sch, 4x_laser_controller_fp.step, bom.csv, cube.stl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]
2022-12-08 Added more PCBs
    [15v_power.kicad_pcb, 15v_power.kicad_sch, 15v_power.step, analog_to_pwm.kicad_pcb, analog_to_pwm.kicad_sch, analog_to_pwm_fp.kicad_pcb, analog_to_pwm_fp.kicad_sch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]
2022-12-22 Improved laser driver design
    The laser driver now allows you to switch between two different brightnesses with an external switch
    [mini_laser_driver.kicad_pcb, mini_laser_driver.kicad_sch]
2022-12-29 Updated laser driver fab files
    [bom.csv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]
2023-01-01 Added DB25 right angle adapter
    [db25_adapter.kicad_pcb, db25_adapter.kicad_sch]
2023-01-10 Updated laser driver silkscreen
    [mini_laser_driver.kicad_pcb]
2023-01-24 Added laser PWM control
2023-04-19 Added calibration routines and changed longs to ints and floats
    [4x_laser_controller.kicad_pcb, 4x_laser_controller.kicad_sch, bom.csv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]
2023-06-02 Added perspective adjustment
    [bom.csv, mega_laser_driver.kicad_pcb, mega_laser_driver.kicad_sch]
2023-06-05 Bug fixes and speed improvements
    [Basics.cpp, Basics.h, Calibration.cpp, Calibration.h, Gpio.cpp, Gpio.h, Laser.cpp, Laser.h]
2023-06-13 Implemented a mostly-working frame buffer
2023-06-14 Got the frame buffer working
2023-07-27 Added new hardware
    [bom.csv, canbus_adapter.kicad_pcb, canbus_adapter.kicad_sch, canbus_controller.kicad_pcb, canbus_controller.kicad_sch, designators.csv, mega_laser_driver.kicad_pcb, mega_laser_driver.kicad_sch]
2023-08-15 Added final laser modes
2023-08-20 Added equations and improved calibration mode
2023-11-15 Minor pcb edits
2023-11-15 Updated to latest versions
    [15v_power.kicad_pcb, 15v_power.kicad_sch, 15v_power.step, 4x_laser_controller.kicad_pcb, 4x_laser_controller.kicad_sch, 4x_laser_controller_fp.kicad_pcb, 4x_laser_controller_fp.kicad_sch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]
2023-11-15 Removed sACN streaming from laser
2023-11-16 Added http requests to laser
2023-11-18 Added a timeout to cut laser power
2023-11-21 Added sACN support for the UI board
2024-01-10 Switched ui from tkinter to pygame
2024-01-29 Some minor bug fixes
    [INA219.py]
2024-01-30 Updated button light handler
2024-02-06 Updated laser simulator
2024-02-07 Added laser object graphics
2024-02-08 Added more laser graphics examples
2024-02-13 Got laser hardware working with waitress
2024-03-11 Switched from TCP to UDP
2024-03-11 Optimized laser server
2024-04-03 Added more laser graphics
2024-04-15 Allowed wands to play effect samples
2024-04-24 Wand calibration updates
2024-04-24 Updated wand calibration
2024-05-07 Made synth updates threaded
2024-06-25 Added notes
    [bom2.csv]
2024-06-28 Added wand button short/long press
2024-06-28 Added firework effect on wand button press
2024-06-28 Updated button press logic
2024-10-09 Switched to UDP
2024-10-15 Updated calibration procedure
